SageRobots/RoboRoller/Manuals/carriage.webp

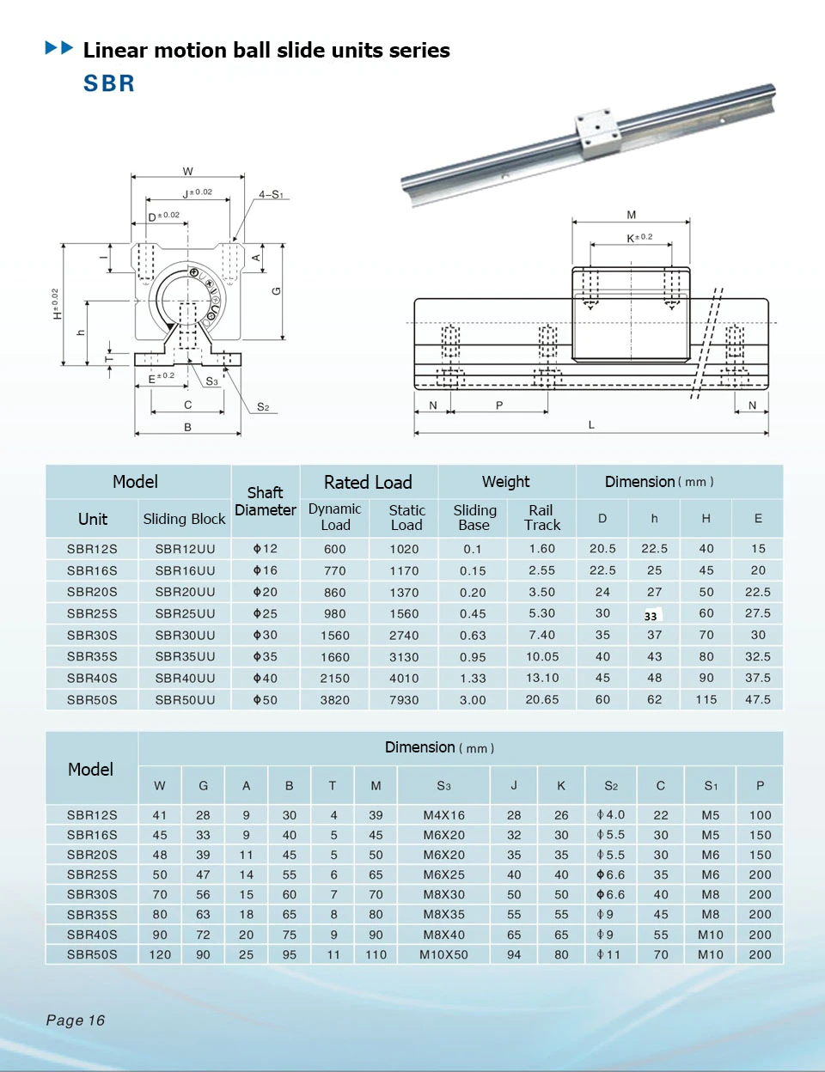
Manuals/carriage.webp
