SageRobots/RoboRoller/Cable Pinouts.ods

Load Cell Cable
1 | GND | BLK | 1 | VCC | RED
2 | Data | YEL | 2 | GND | BLK
3 | Clock | WHT | 3 | Clock | WHT
4 | VCC | RED | 4 | Data | YEL
Encoder Cable Z
1 | 2 | 3V3 | GND | RED | BLK
3 | 4 | CLK | MISO | WHT | YEL
5 | 6 | CS | MOSI | ORG | GRN
1 | 3V3 | RED
2 | GND | BLK
3 | CLK | WHT
4 | MISO | YEL
5 | CS | ORG
6 | MOSI | GRN
Home Cable
1 | 3V3 | RED | 1 | 3V3 | RED
2 | OUT | YEL | 2 | GND | BLK
3 | GND | BLK | 3 | OUT | YEL
Encoder Cable X
2 | 1 | 3V3 | GND | RED | BLK
4 | 3 | CLK | MISO | WHT | YEL
6 | 5 | CS | MOSI | ORG | GRN
1 | 3V3 | RED
2 | GND | BLK
3 | CLK | WHT
4 | MISO | YEL
5 | CS | ORG
6 | MOSI | GRN
Motor X Extension
