SageRobots/RoboRoller/BOM_MuscleRoller.ods

Type | Item | Sage Robots PN | Mfr | Mfr PN | Supplier | Price | Unit | Qty | Material Mfr | Material PN | Note
SUB | Frame |  |  |  |  |  |  | 1
FAB | Base | MR_BASE_1V0 | Sage Robots |  |  |  |  | 1
COM | Aluminum bracket 7in | AL_BRACK_7IN | NovelBee | B0833PR3L1 | Amazon | $5.39 |  | 2
COM | Screw M5x40 FH | SCREW_M5X25_F |  |  | McMaster |  |  | 4
COM | Nut M5 |  |  |  |  |  |  | 4
COM | Washer M5 oversize |  |  |  |  |  |  | 8 |  |  | Every hole in large brackets
FAB | Bar A | MR_BAR_A_1V0 | Sage Robots |  |  |  |  | 2
COM | M5x12 screw |  |  |  |  |  |  | 4 |  |  | Bracket to bar A
FAB | End cap 2020 | MR_END_CAP_1V0 | Sage Robots |  |  |  |  | 2
COM | M5 t nut |  |  |  |  |  |  | 6 |  |  | 4x bracket to bar A, 2x PCB bracket
COM | M5x10 screw |  |  |  |  |  |  | 2 |  |  | PCB bracket
SUB | X axis assembly |  |  |  |  |  |  | 1
COM | 500mm linear rail with carriages |  |  |  |  |  |  | 3
COM | M3 t nut |  |  |  |  |  |  | 4
COM | M3x14 screw |  | McMaster |  |  |  |  | 6 |  |  | Rails to bar As, 2x motor bracket
COM | M3 oversize washer |  |  |  |  |  |  | 4 |  |  | Rails to bar As
COM | Stepper motor | MTR |  |  |  |  |  | 1
FAB | Motor bracket X | MR_MTR_BRACK_X_1V0 | Sage Robots |  |  |  |  | 1
COM | M3x12 flathead screw |  |  |  |  |  |  | 4 |  |  | Motor to motor bracket
COM | M3x10 screw |  | McMaster |  |  |  |  | 4
COM | M5 t nut |  |  |  |  |  |  | 7 |  |  | 2x motor bracket, 2x encoder bracket, 2x carrier brack A, 1x mag sw PCBA
COM | M5x10 screw |  |  |  |  |  |  | 4 |  |  | 2x motor bracket, 2x enc brack
COM | Coupler 5 to 8mm |  |  |  |  |  |  | 1
FAB | Lead screw X | MR_LEAD_SCREW_X_1V0 |  |  |  |  |  | 1
FAB | Lead nut bracket X | MR_LEAD_NUT_BRACK_X_1V0 | Sage Robots |  |  |  |  | 1
COM | M3x20 screw |  |  |  |  |  |  | 8 |  |  | 4x lead nut to brack, 2x brack to rail, 2x mag brack
COM | M3 nut |  |  |  |  |  |  | 20 |  |  | 6x carrier, 2x carrier brack B, 2x lead nut brack, 4x lead nut, 4x z rail, 2x mag brack
FAB | Magnet coupler | MR_MAG_COUPLER_1V0 | Sage Robots |  |  |  |  | 1
COM | Diametric magnet 6x2.5mm |  |  |  | Digikey |  |  | 1
COM | M3x4 set screw |  |  |  |  |  |  | 1
COM | M3 square nut |  |  |  |  |  |  | 1
FAB | Encoder bracket X | MR_ENC_BRACK_X_1V0 | Sage Robots |  |  |  |  | 1
COM | #4x5/16 screw for plastic |  |  |  |  |  |  | 1 |  |  | Encoder PCB to bracket
COM | M5x16 screw |  |  |  |  |  |  | 2 |  |  | Enc brack x to bar A
COM | M5x6 screw |  |  |  |  |  |  | 1 |  |  | Mag sw PCBA
FAB | Carriage plate X | MR_CARRIAGE_PLATE_X_1V0 | Sage Robots |  |  |  |  | 2
FAB | Encoder bracket Z |  |  |  |  |  |  | 1
COM | #8x0.75 screw for plastic |  |  |  |  |  |  | 2
COM | Magnet |  |  |  | Digikey |  |  | 1
COM | M3x12 screw |  |  |  |  |  |  | 16
COM | Cable carrier |  |  |  |  |  |  | 1
FAB | Carrier bracket A | MR_CARRIER_BRACK_A_1V0 | Sage Robots |  |  |  |  | 1
 | M5x12 screw |  |  |  |  |  |  | 2 |  |  | Carrier bracket A
FAB | Carrier bracket B | MR_CARRIER_BRACK_B_1V0 | Sage Robots |  |  |  |  | 1
 | M3x16 flat head screw |  |  |  |  |  |  | 6 |  |  | 3x carrier to carrier brack B, 3x carrier to brack A
 | M3x16 screw |  |  |  |  |  |  | 4 |  |  | 4x z rail to carriage plate x
SUB | Z axis assembly |  |  |  |  |  |  | 1
COM | 450mm lead screw with nut |  |  |  |  |  |  | 1
COM | M3x20 screw |  |  |  |  |  |  | 8
 | M3 nut |  |  |  |  |  |  | 8
FAB | Motor bracket Z | MR_MTR_BRACK_Z_1V0 |  |  |  |  |  | 1
 | M3x12 screw |  |  |  |  |  |  | 12 |  |  | 8x carriage plate z to carriages
 | M3 oversize washer |  |  |  |  |  |  | 2
 | Stepper motor |  |  |  |  |  |  | 1
 | M3x8 screw |  |  |  |  |  |  | 4
 | Coupler 5 to 8mm |  |  |  |  |  |  | 1
FAB | Magnet coupler |  |  |  |  |  |  | 1
COM | Diametric magnet 6x2.5mm |  |  |  | Digikey |  |  | 1
COM | M3x4 set screw |  |  |  |  |  |  | 1
 | M3 square nut |  |  |  |  |  |  | 1
 | Home bracket Z |  |  |  |  |  |  | 1
 | M5x10 screw |  |  |  |  |  |  | 1
 | M5 nut |  |  |  |  |  |  | 1
 | Lead nut bracket Z |  |  |  |  |  |  | 1
 | M4x40 flat head screw |  |  |  |  |  |  | 2 |  |  | 2x lead nut to carriage plate
 | M4 nut |  |  |  |  |  |  | 2
 | Carriage plate Z |  |  |  |  |  |  | 1
 | Magnet |  |  |  |  |  |  | 1
COM | #4x5/16 screw for plastic |  |  |  |  |  |  | 1 |  |  | Encoder PCB to bracket
SUB | Roller assembly |  |  |  |  |  |  | 1
 | Aluminum bracket mm |  |  |  |  |  |  | 2
 | M5x25 screw |  |  |  |  |  |  | 4
 | M5 nut |  |  |  |  |  |  | 4
 | M5x14 screw |  |  |  |  |  |  | 8
 | M5 t nut |  |  |  |  |  |  | 14 |  |  | 4x LC PCB bracks, 2x carrier brack D, 4x LC brack Bs, 4x Al bracks
FAB | Bar B |  |  |  |  |  |  | 2
 | Load cell bracket B |  |  |  |  |  |  | 2
 | M4x55 screw |  |  |  |  |  |  | 4
 | Load cell 20kg |  | ShangHJ | B09CQHY73K |  |  |  | 2
 | Load cell bracket |  |  |  |  |  |  | 1
 | Load cell bracket A |  |  |  |  |  |  | 1
 | M4x20 screw |  |  |  |  |  |  | 4
 | Shoulder screw 1.25in 10-24 |  |  |  |  |  |  | 4
 | Spring |  |  |  |  |  |  | 4
 | 10-24 square nut |  |  |  |  |  |  | 4
 | Roller bracket |  |  |  |  |  |  | 2
 | Shaft 10mm |  |  |  |  |  |  | 1
 | Bearing 10mm |  |  |  |  |  |  | 2
 | Roller cap |  |  |  |  |  |  | 2
 | Roller |  |  |  |  |  |  | 1
 | Cable carrier |  |  |  |  |  |  | 1
 | Carrier bracket C |  |  |  |  |  |  | 1
 | M3x20 screw |  |  |  |  |  |  | 2
 | M3 nut |  |  |  |  |  |  | 8
 | M3x10 flat head screw |  |  |  |  |  |  | 3
 | Carrier bracket D |  |  |  |  |  |  | 1
 | M3x16 flat head screw |  |  |  |  |  |  | 3 |  |  | Carrier to carrier brack D
 | M5x10 screw |  |  |  |  |  |  | 6 |  |  | 4x LC PCB bracks, 2x carrier brack D
 | Load cell PCB bracket |  |  |  |  |  |  | 2
 | #3x0.25 screw |  |  |  |  |  |  | 4
 | Load cell PCB |  |  |  |  |  |  | 2
SUB | PCB assembly |  |  |  |  |  |  | 1
FAB | Muscle roller PCB |  |  |  | JLCPCB |  |  | 1
COM | DRV8825 breakout |  |  |  |  |  |  | 2
COM | Female header 8 pos P2.54 |  | Adam Tech | RS1-08-G | Digikey |  |  | 4
COM | Capacitor 100u |  | KEMET | EDK107M016A9GAA | Digikey |  | $0.39 | 0 |  |  | C2, C3
COM | Capacitor 100u |  | Würth Elektronik | 865080343009 | Digikey |  | $0.27 | 2 |  |  | C2, C3
COM | Capacitor 0805 22u |  | Samsung Electro-Mechanics | CL21A226MOQNNNE‎ | Digikey |  |  | 2 |  |  | C1, C5
COM | Capacitor 0805 0.1u |  | Samsung Electro-Mechanics | CL21F104ZAANNNC | Digikey |  |  | 1 |  |  | C6
COM | Capacitor 0805 1u |  | Samsung Electro-Mechanics | CL21B105KOFNNNE | Digikey |  |  | 1 |  |  | C4
COM | Connector 1x6 male |  | JST |  |  |  |  | 2
COM | Screw terminal 1x2 |  | Adam Tech | EBBA-02-C-SS-BU | Digikey |  |  | 2
COM | Connector 1x4 |  | JST |  |  |  |  | 4
COM | Connector 1x3 |  | JST |  | Digikey |  |  | 2
COM | Pin header 1x3 P2.54 |  |  |  |  |  |  | 1
COM | Resistor 0805 47k |  |  |  |  |  |  | 2 |  |  | R1, R3
COM | Resistor 0805 10k |  |  |  |  |  |  | 3 |  |  | R2, R4, R5
COM | Tactile switch |  | E-Switch | TL3305AF160QG | Digikey |  |  | 2
COM | DC DC converter 3.3Vout |  | Diodes Incorporated | AZ1117IH-3.3TRG1 | Digikey |  |  | 0
COM | DC DC converter 3.3Vout |  | STMicroelectronics | LD1117ADT33TR | Digikey |  | $0.63 | 1
COM | WiFi BT microcontroller |  | Espressif | ESP32-WROOM-32E | Digikey |  |  | 1
SUB | Z motor cable assembly |  |  |  |  |  |  | 1
 | Cable 4 cond 26AWG |  |  |  |  |  | m | 0.13
 | Connector 1x4 female |  | JST |  |  |  |  | 1
COM | Crimp contact |  | JST |  |  |  |  | 4
 | Connector 1x4 female |  | TE |  |  |  |  | 1
COM | Crimp contact female |  | TE |  |  |  |  | 4
 | Connector 1x4 male |  | TE |  |  |  |  | 1
COM | Crimp contact male |  | TE |  |  |  |  | 4
SUB | Load cell cable assembly |  |  |  |  |  |  | 2
 | Cable 4 cond 22AWG |  |  |  |  |  | m | 1.4
 | Connector 1x4 female |  | JST |  |  |  |  | 3
COM | Crimp contact |  | JST |  |  |  |  | 12
SUB | Encoder PCB assembly |  |  |  |  |  |  | 2
 | Encoder PCB |  |  |  | JLCPCB |  |  | 1
 | Magnetic encoder |  | AMS | 5047D |  |  |  | 1
 | Capacitor 0805 0.1u |  |  |  |  |  |  | 1
 | Header male 2x3 P2 |  |  |  | Digikey |  |  | 1
SUB | Encoder cable assembly |  |  |  |  |  |  | 2
 | Cable 6 cond 26AWG |  |  |  |  |  | m | 1
 | Connector 2x3 female P2 |  |  |  |  |  |  | 1
 | Crimp contact female |  |  |  |  |  |  | 6
 | Connector 1x6 female |  | JST |  |  |  |  | 1
COM | Crimp contact female |  | JST |  |  |  |  | 6
SUB | Magnetic switch PCB assembly |  |  |  |  |  |  | 2
 | Magnetic switch PCB |  |  |  | JLCPCB |  |  | 1
 | Magnetic switch omnipolar |  |  |  |  |  |  | 1
 | Connector 1x3 male |  | JST |  |  |  |  | 1
SUB | Magnetic switch cable assembly Z |  |  |  |  |  |  | 2
 | Cable 3 cond 26AWG |  |  |  |  |  | m | 1.3
 | Connector 1x3 female |  | JST |  |  |  |  | 2
COM | Crimp contact female |  | JST |  |  |  |  | 6
