SageRobots/RoboRoller/FreeCAD/4000-0006-0008 assembly.STEP

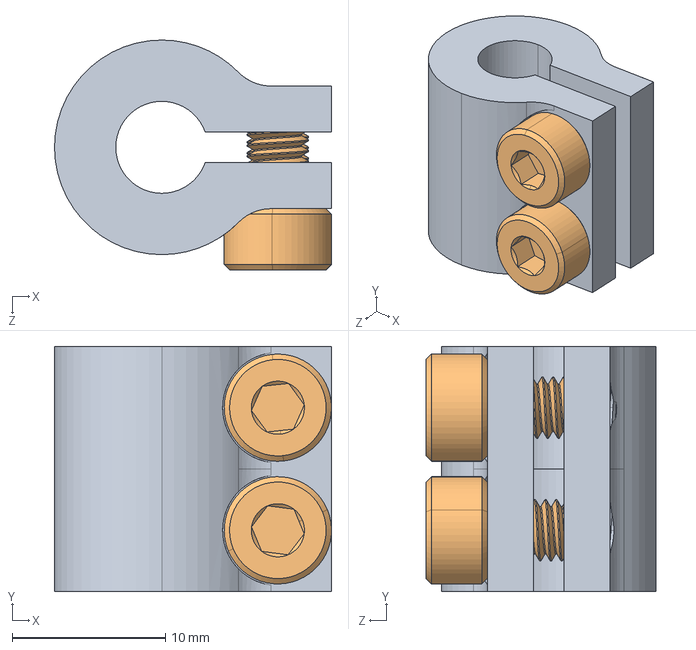
[picture p2: CAD file, 2021-10-21]
FreeCAD/4000-0006-0008 assembly.STEP
18.1 x 16.0 x 15.0 mm
2800-0004-0008_90128A207 x 2
