SageRobots/RoboRoller/FreeCAD/AL_BRACKET.FCStd

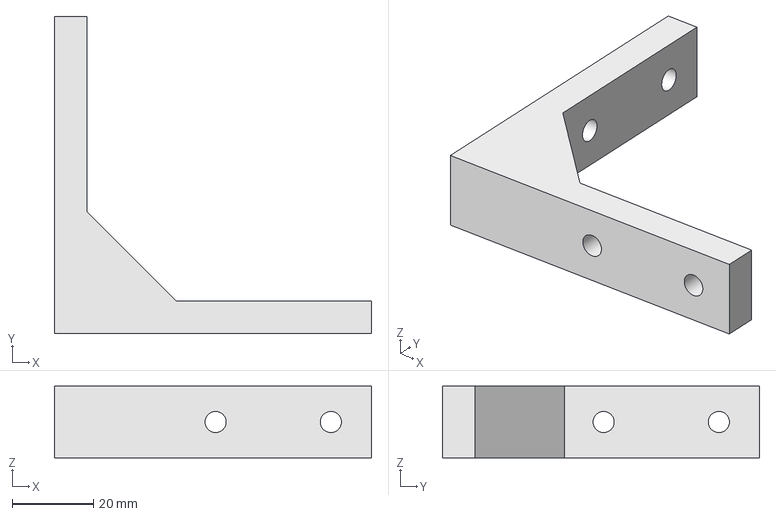
[picture p3: CAD file, 2022-08-25]
FreeCAD/AL_BRACKET.FCStd
78.0 x 78.0 x 17.7 mm
