SageRobots/RoboRoller/STL/Z_MAG_BRACK_1V0.stl

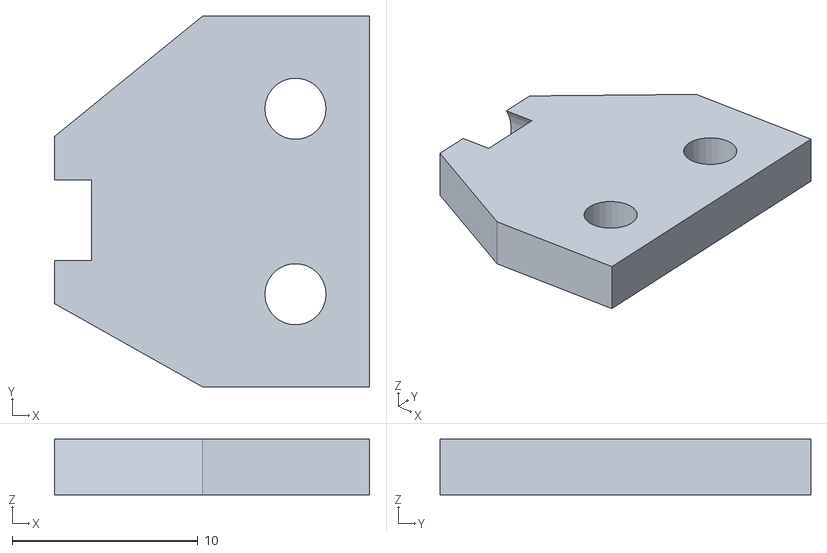
[picture p4: CAD file, 2022-07-25]
STL/Z_MAG_BRACK_1V0.stl
17.0 x 20.0 x 3.00
