SageRobots/RoboRoller/FreeCAD/AL_BRACKET_A.FCStd

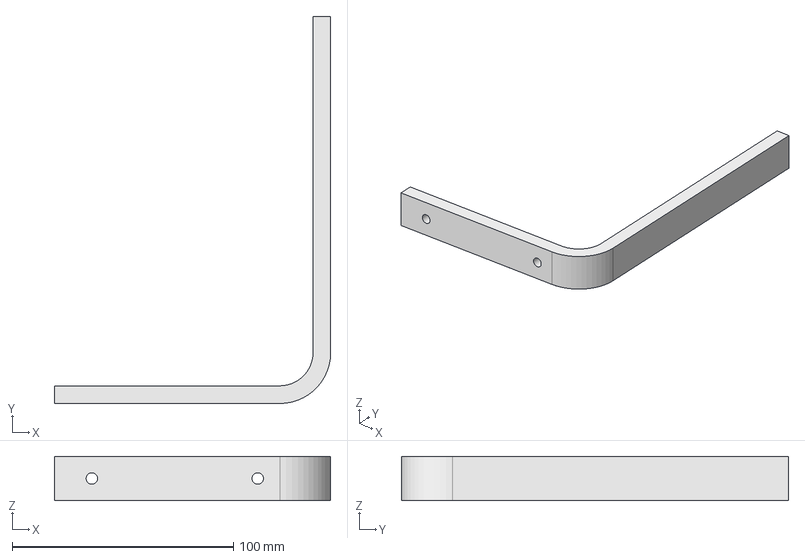
[picture p5: CAD file, 2022-08-25]
FreeCAD/AL_BRACKET_A.FCStd
125.0 x 175.0 x 20.0 mm
