SageRobots/RoboRoller/STL/X_MAG_BRACK_1V0.stl

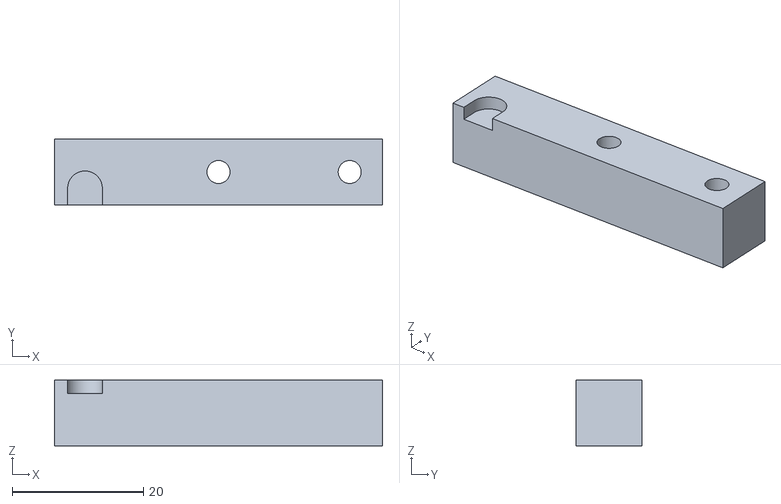
[picture p6: CAD file, 2022-07-25]
STL/X_MAG_BRACK_1V0.stl
50.0 x 10.0 x 10.0
