SageRobots/RoboRoller/FreeCAD/MTR_17HS15_1504S.FCStd

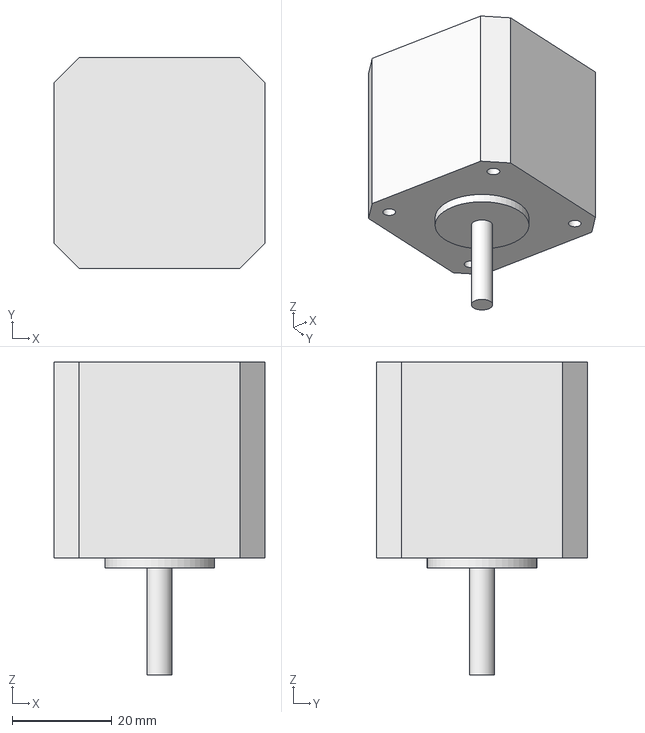
[picture p7: CAD file, 2022-08-25]
FreeCAD/MTR_17HS15_1504S.FCStd
42.3 x 42.3 x 62.8 mm
