SageRobots/RoboRoller/STL/LC_PCB_BRACK_1V0.stl

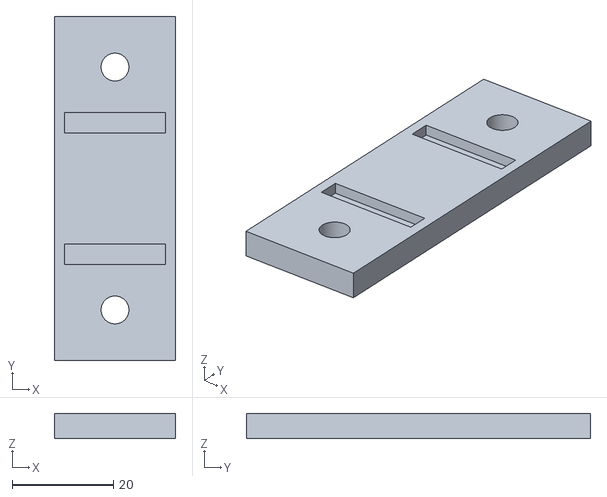
[picture p8: CAD file, 2022-07-12]
STL/LC_PCB_BRACK_1V0.stl
24.0 x 68.0 x 5.00
