SageRobots/RoboRoller/STL/ROLLER_CAP_1V0.stl

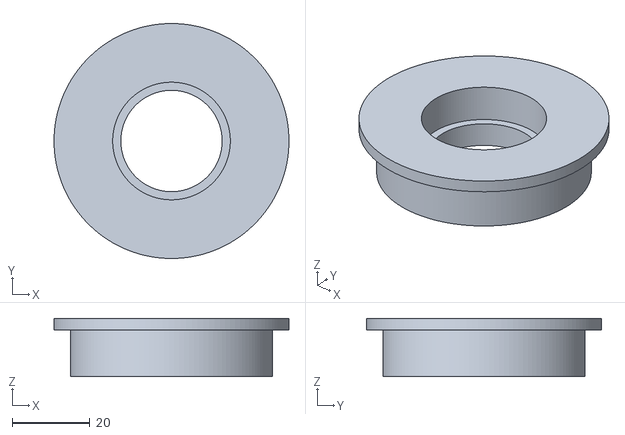
[picture p9: CAD file, 2022-07-12]
STL/ROLLER_CAP_1V0.stl
60.3 x 60.3 x 15.0
