SageRobots/RoboRoller/FreeCAD/LOAD-CELL-4543.FCStd

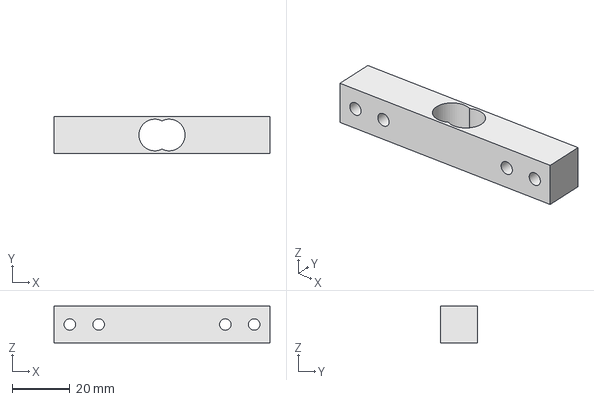
[picture p10: CAD file, 2022-08-25]
FreeCAD/LOAD-CELL-4543.FCStd
75.0 x 12.7 x 12.7 mm
