SageRobots/RoboRoller/STL/ENC_BRACK_Z_1V0.stl

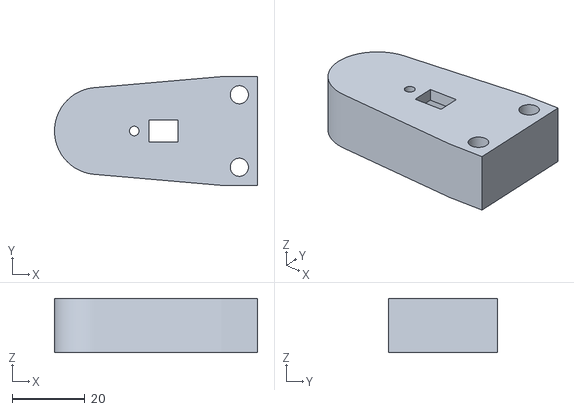
[picture p11: CAD file, 2022-06-04]
STL/ENC_BRACK_Z_1V0.stl
56.0 x 30.0 x 15.0
