SageRobots/RoboRoller/FreeCAD/MUSCLE_ROLLER_1V0.FCStd

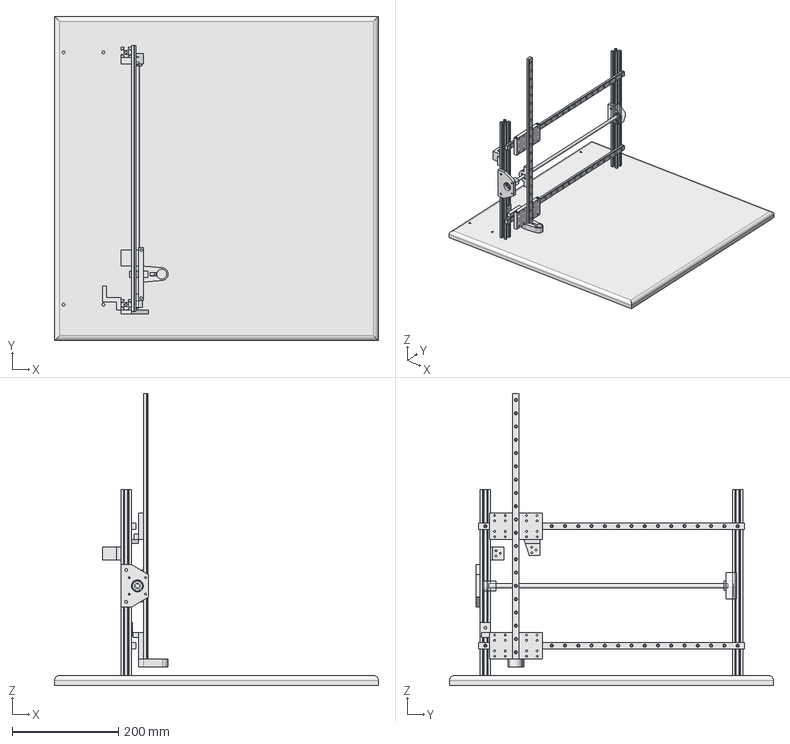
[picture p12: CAD file, 2022-08-25]
FreeCAD/MUSCLE_ROLLER_1V0.FCStd
610.0 x 610.0 x 550.4 mm
