SageRobots/RoboRoller/STL/ENC_BRACK_X_1V0.stl

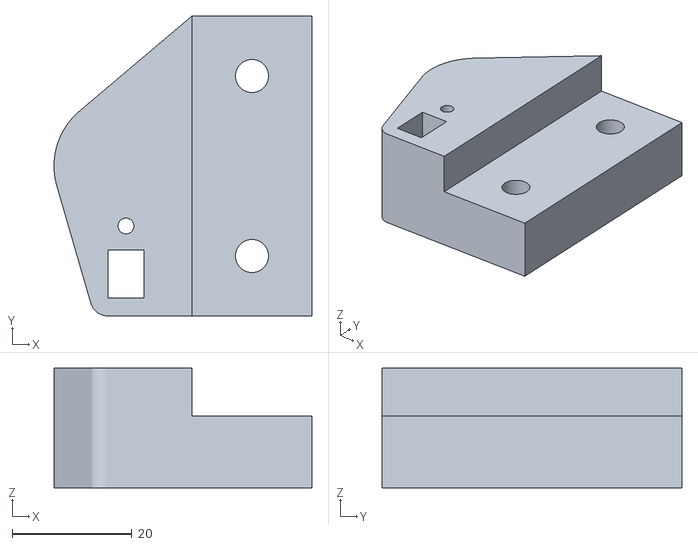
[picture p13: CAD file, 2022-06-04]
STL/ENC_BRACK_X_1V0.stl
43.0 x 50.0 x 20.0
