SageRobots/RoboRoller/FreeCAD/SPRING.FCStd

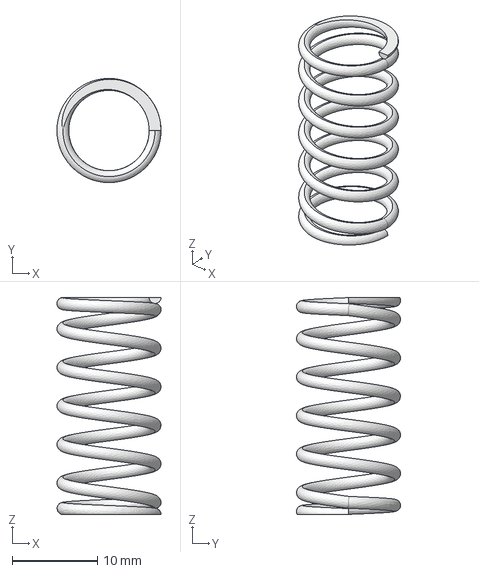
[picture p14: CAD file, 2022-08-25]
FreeCAD/SPRING.FCStd
12.2 x 12.2 x 25.4 mm
