SageRobots/RoboRoller/STL/PCB_BRACK_1V0.stl

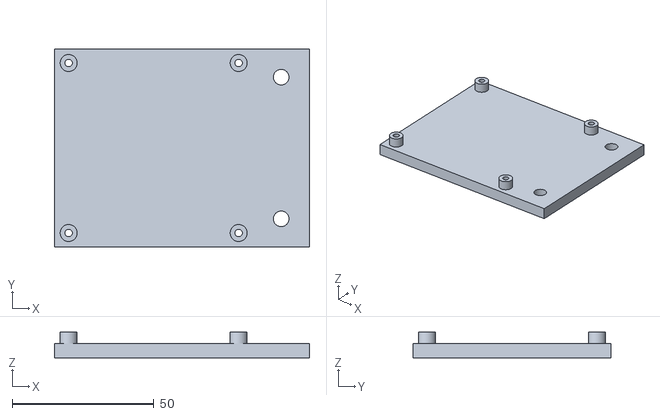
[picture p15: CAD file, 2022-06-04]
STL/PCB_BRACK_1V0.stl
90.0 x 70.0 x 9.00
