SageRobots/RoboRoller/FreeCAD/CARRIAGE_MGN12H.FCStd

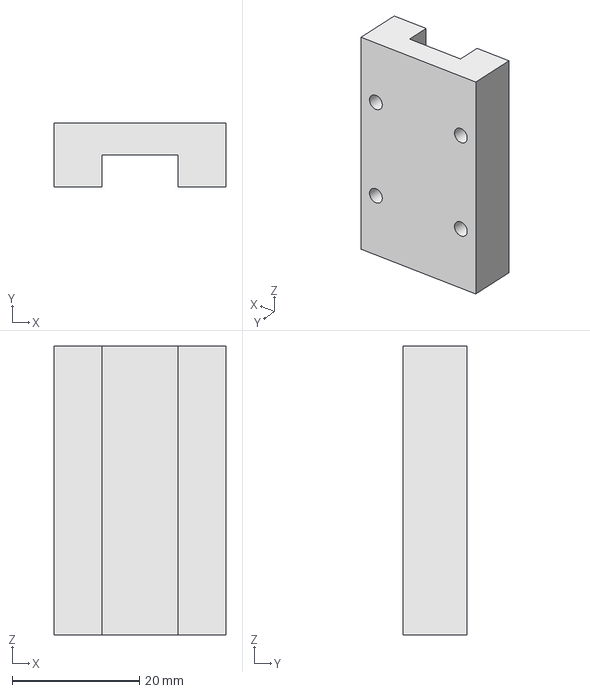
[picture p16: CAD file, 2022-08-25]
FreeCAD/CARRIAGE_MGN12H.FCStd
27.0 x 10.0 x 45.4 mm
