SageRobots/RoboRoller/STL/MTR_BRACK_Z_1V0.stl

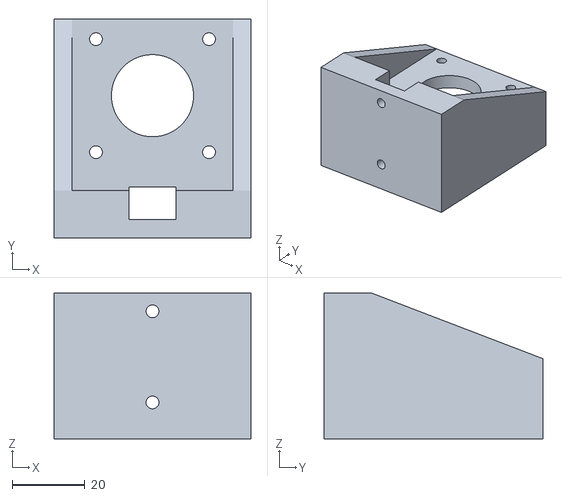
[picture p17: CAD file, 2022-06-04]
STL/MTR_BRACK_Z_1V0.stl
54.0 x 60.0 x 40.0
