SageRobots/RoboRoller/FreeCAD/CARRIAGE_SBR16.FCStd

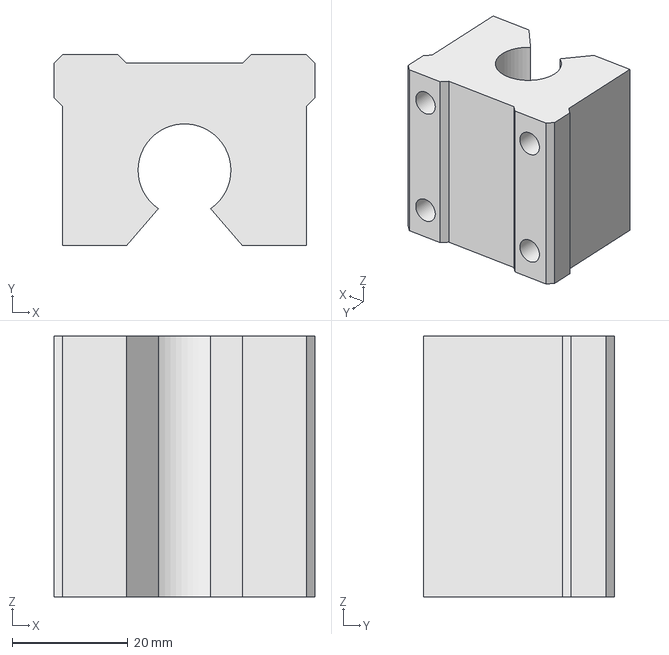
[picture p18: CAD file, 2022-01-11]
FreeCAD/CARRIAGE_SBR16.FCStd
45.0 x 33.0 x 45.0 mm
