SageRobots/RoboRoller/STL/CARRIER_BRACK_B_1V0.stl

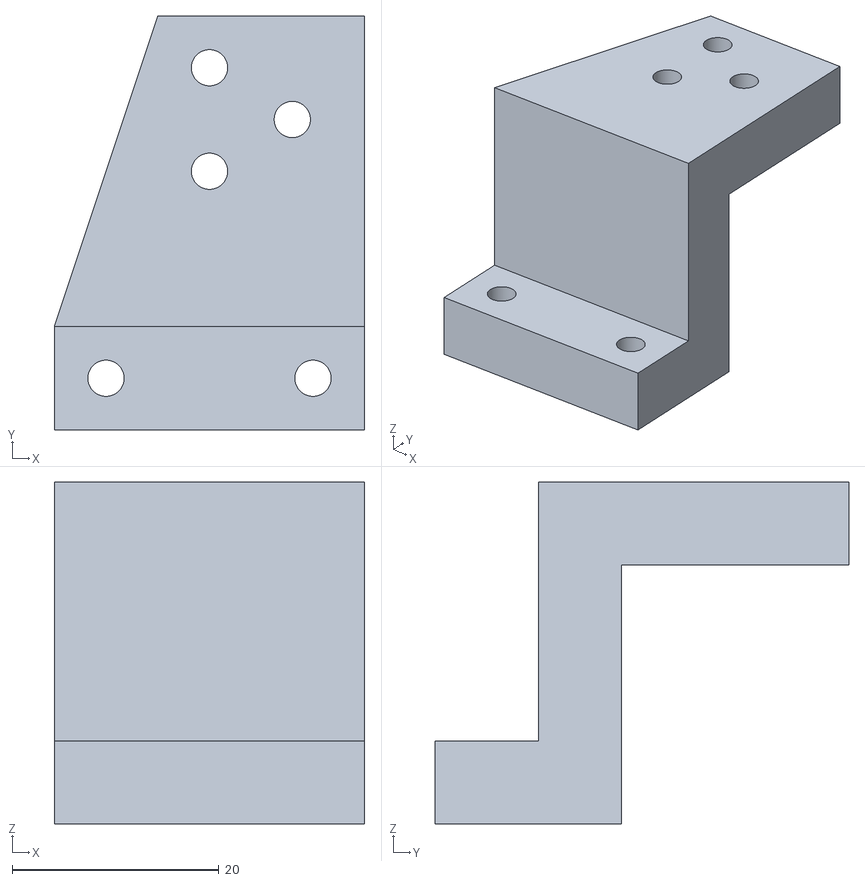
[picture p19: CAD file, 2022-01-28]
STL/CARRIER_BRACK_B_1V0.stl
30.0 x 40.0 x 33.0
