SageRobots/RoboRoller/FreeCAD/V-WHEEL-2020.FCStd

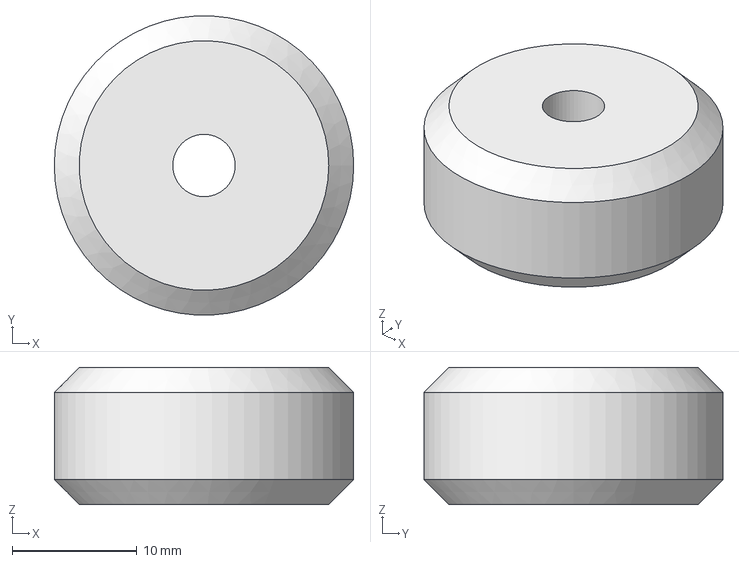
[picture p20: CAD file, 2021-12-02]
FreeCAD/V-WHEEL-2020.FCStd
24.0 x 24.0 x 11.0 mm
