SageRobots/RoboRoller/STL/CARRIER_BRACK_C_1V0.stl

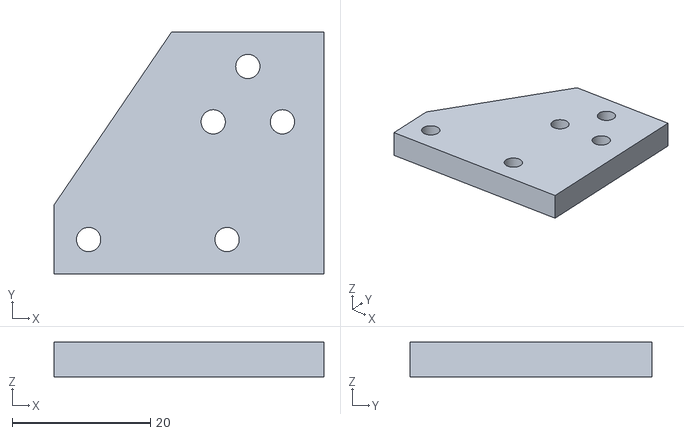
[picture p21: CAD file, 2022-01-28]
STL/CARRIER_BRACK_C_1V0.stl
39.0 x 35.0 x 5.00
