SageRobots/RoboRoller/FreeCAD/MOTOR-17HS13-0404S-PG27.FCStd

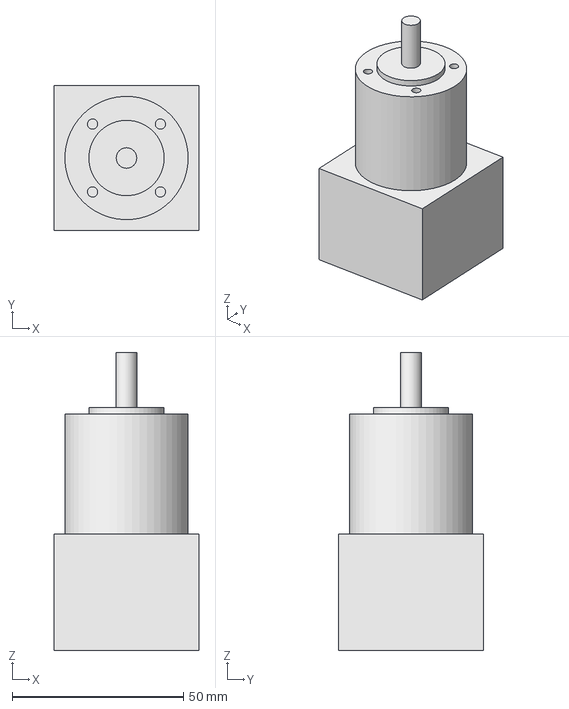
[picture p22: CAD file, 2021-12-02]
FreeCAD/MOTOR-17HS13-0404S-PG27.FCStd
42.3 x 42.3 x 87.0 mm
