SageRobots/RoboRoller/STL/MTR_BRACK_X_1V0.stl

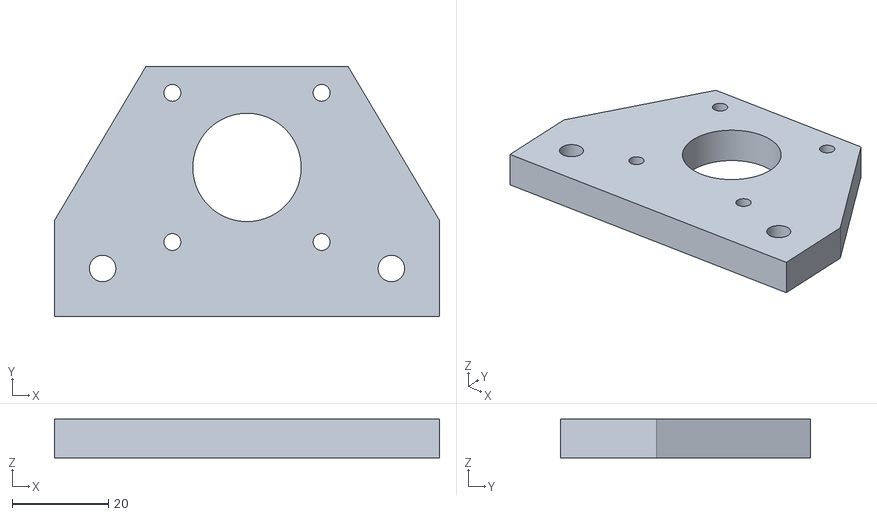
[picture p23: CAD file, 2022-01-28]
STL/MTR_BRACK_X_1V0.stl
80.0 x 52.0 x 8.00
