SageRobots/RoboRoller/STL/CARRIER_BRACK_D_1V0.stl

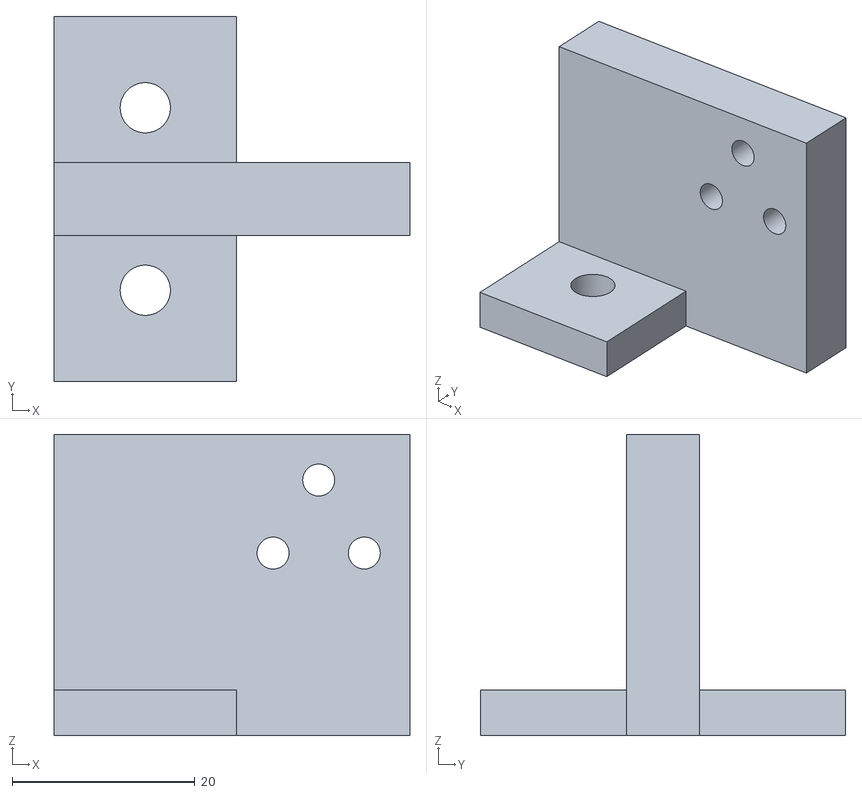
[picture p24: CAD file, 2022-01-28]
STL/CARRIER_BRACK_D_1V0.stl
39.0 x 40.0 x 33.0
