SageRobots/RoboRoller/STL/CARRIER_BRACK_A_1V0.stl

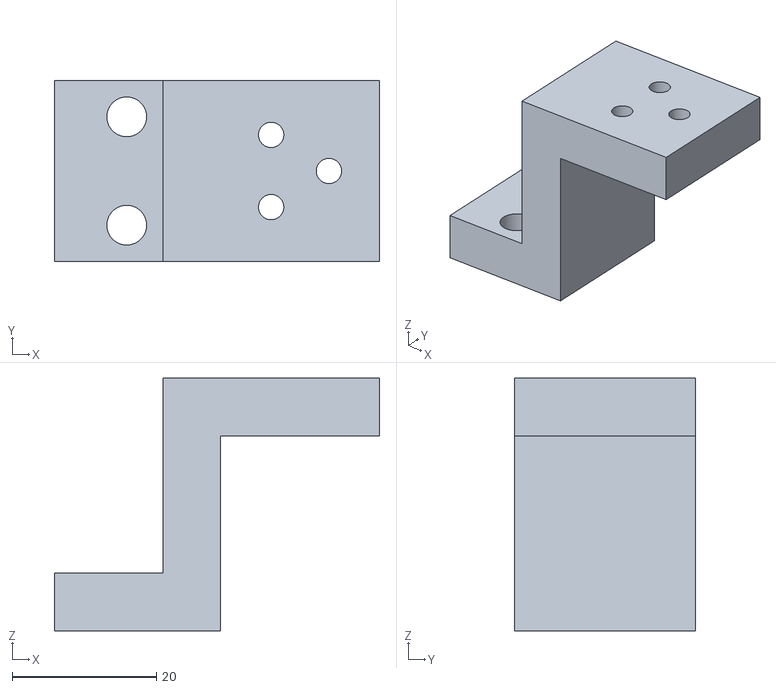
[picture p25: CAD file, 2022-01-28]
STL/CARRIER_BRACK_A_1V0.stl
45.0 x 25.0 x 35.0
