SageRobots/RoboRoller/STL/END_CAP_1V0.stl

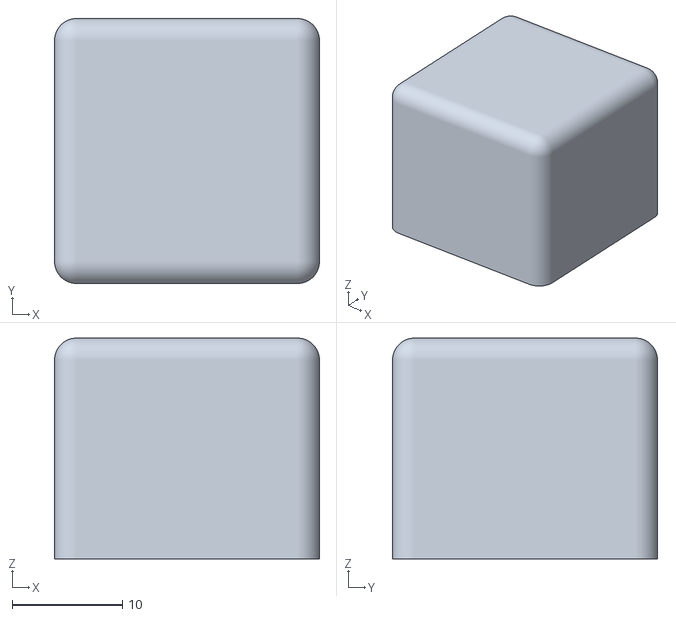
[picture p26: CAD file, 2022-01-28]
STL/END_CAP_1V0.stl
24.0 x 24.0 x 20.0
