SageRobots/RoboRoller/STL/MAGNET_COUPLER_1V0.stl

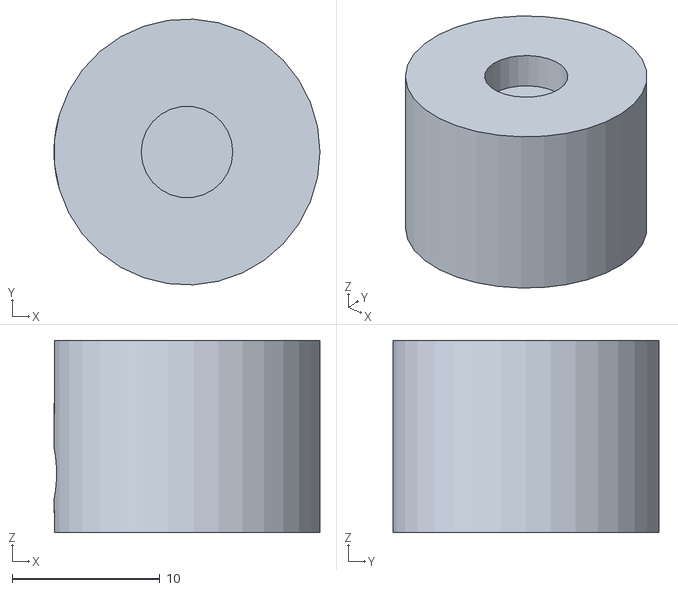
[picture p27: CAD file, 2022-01-28]
STL/MAGNET_COUPLER_1V0.stl
18.0 x 18.0 x 13.0
