SageRobots/RoboRoller/STL/CARRIAGE_PLATE_Z_1V0.stl

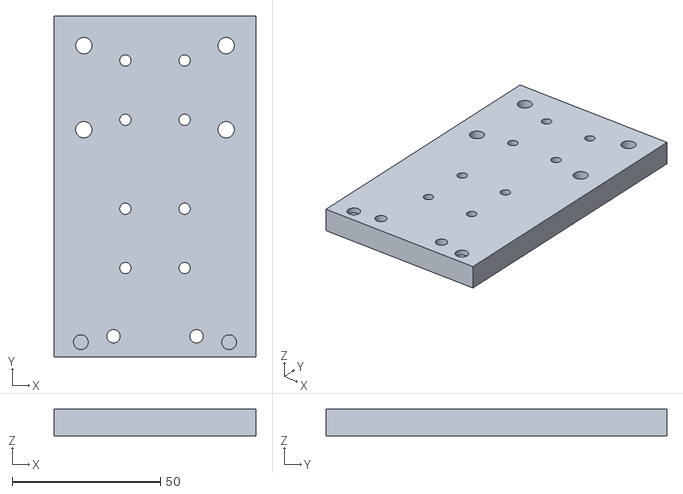
[picture p28: CAD file, 2022-01-28]
STL/CARRIAGE_PLATE_Z_1V0.stl
68.0 x 115.0 x 9.00
