SageRobots/RoboRoller/STL/HOME_BRACK_Z_1V0.stl

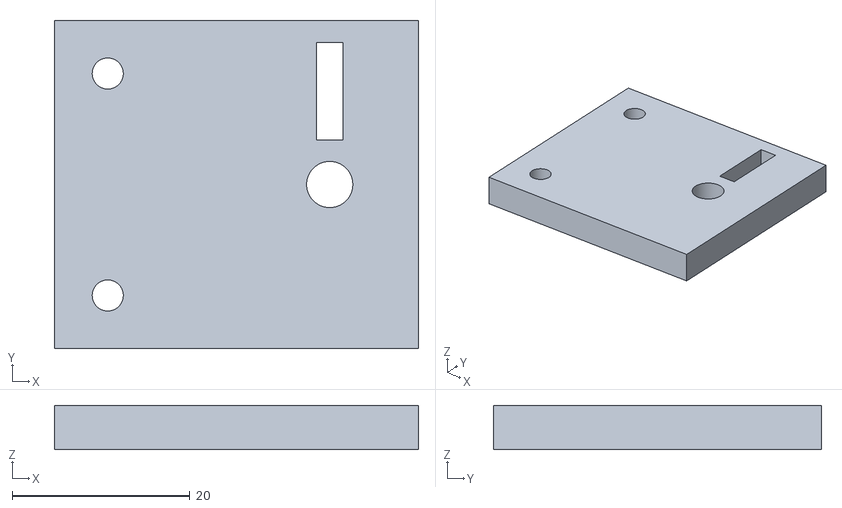
[picture p29: CAD file, 2022-01-28]
STL/HOME_BRACK_Z_1V0.stl
41.0 x 37.0 x 5.00
