SageRobots/RoboRoller/STL/CARRIAGE_PLATE_X_1V0.stl

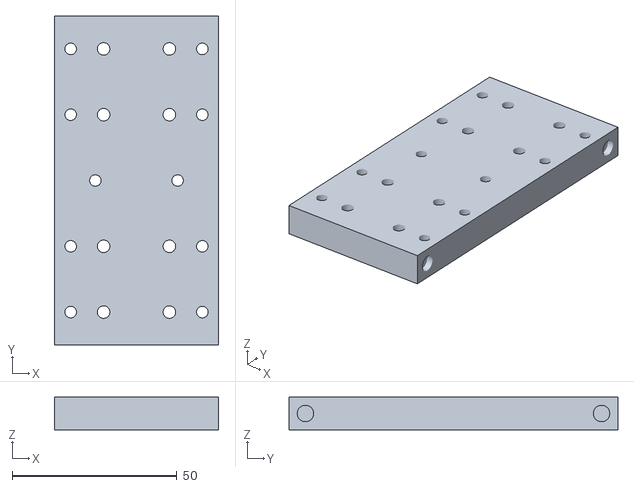
[picture p30: CAD file, 2022-01-28]
STL/CARRIAGE_PLATE_X_1V0.stl
50.0 x 100.0 x 10.0
