SageRobots/RoboRoller/STL/LC_BRACK_B_1V0.stl

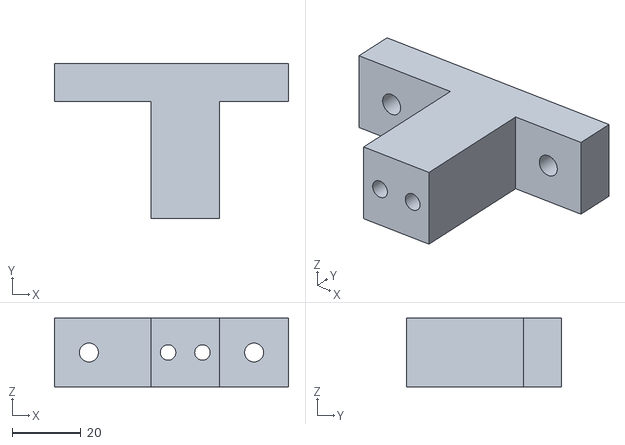
[picture p31: CAD file, 2022-01-28]
STL/LC_BRACK_B_1V0.stl
68.0 x 45.0 x 20.0
