SageRobots/RoboRoller/STL/LC_BRACK_A_1V0.stl

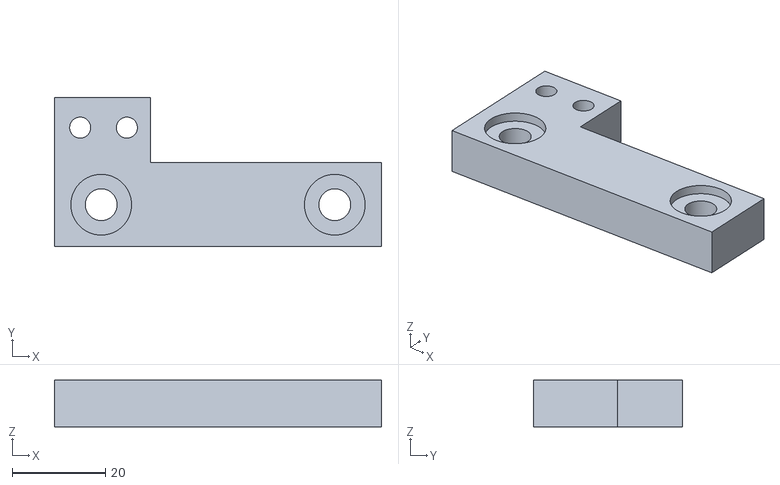
[picture p32: CAD file, 2021-10-22]
STL/LC_BRACK_A_1V0.stl
70.0 x 32.0 x 10.0
