SageRobots/RoboRoller/STL/ROLLER_BRACK_1V0.stl

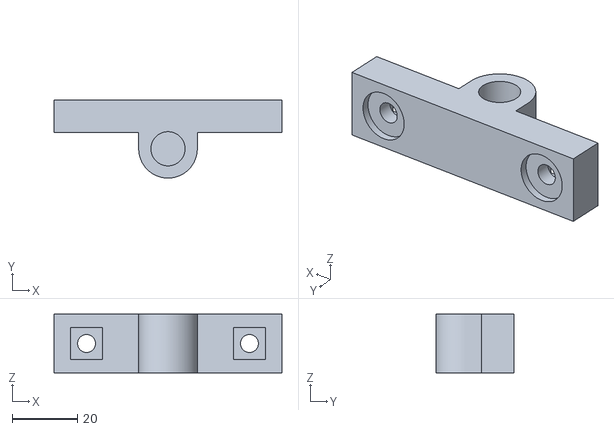
[picture p33: CAD file, 2021-10-22]
STL/ROLLER_BRACK_1V0.stl
70.0 x 24.0 x 18.0
