SageRobots/RoboRoller/(list of files, cad)

Other CAD files:
FreeCAD/COUPLER-6-8.FCStd
STL/LC_BRACK_1V0.stl
FreeCAD/SHOULDER-SCREW.FCStd
STL/LEAD_NUT_BRACK_X_1V0.stl
STL/LEAD_NUT_BRACK_Z_1V0.stl
