SageRobots/RoboRoller/Manuals/4543_diagram.jpg

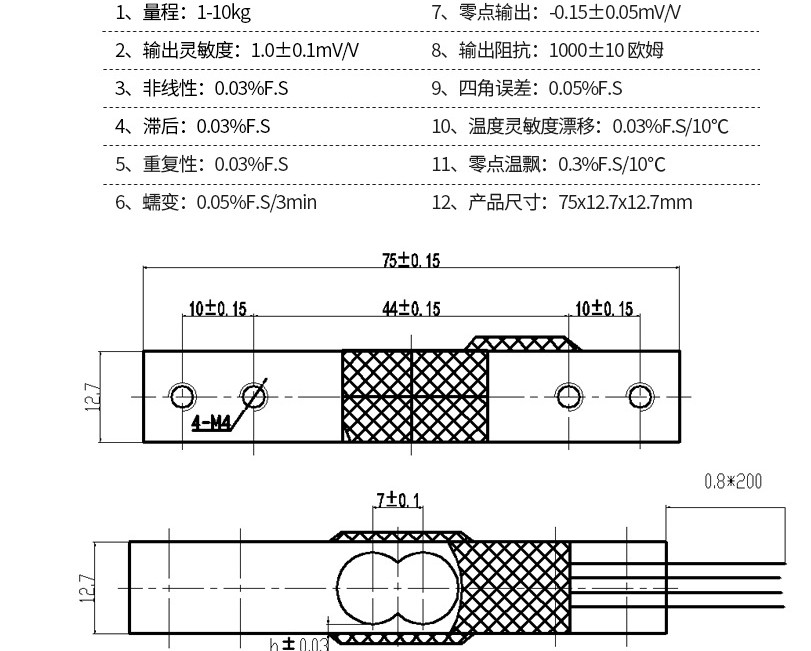
Manuals/4543_diagram.jpg
