SageRobots/RoboRoller/Manuals/cable carrier.jpg

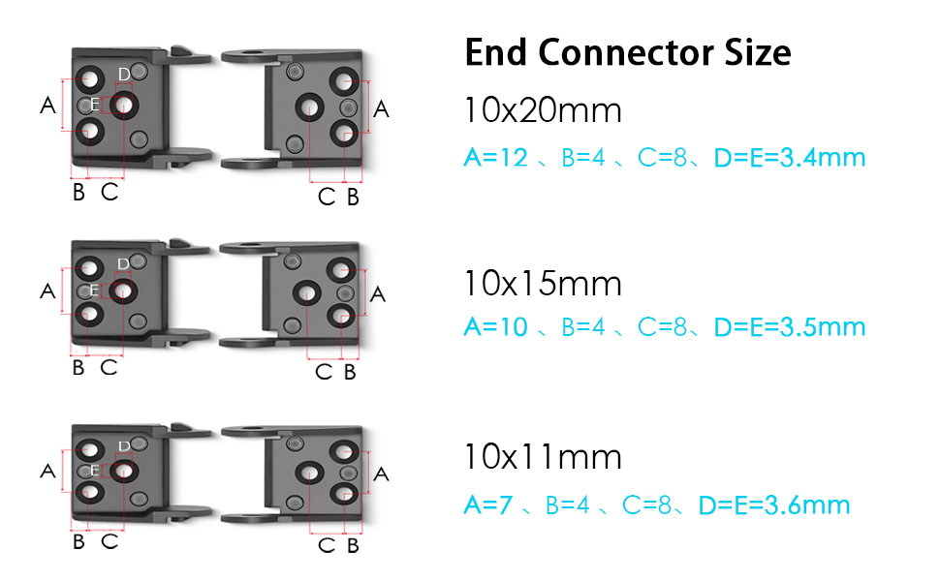
Manuals/cable carrier.jpg
