SageRobots/RoboRoller/Manuals/MGN12H rail.jpg

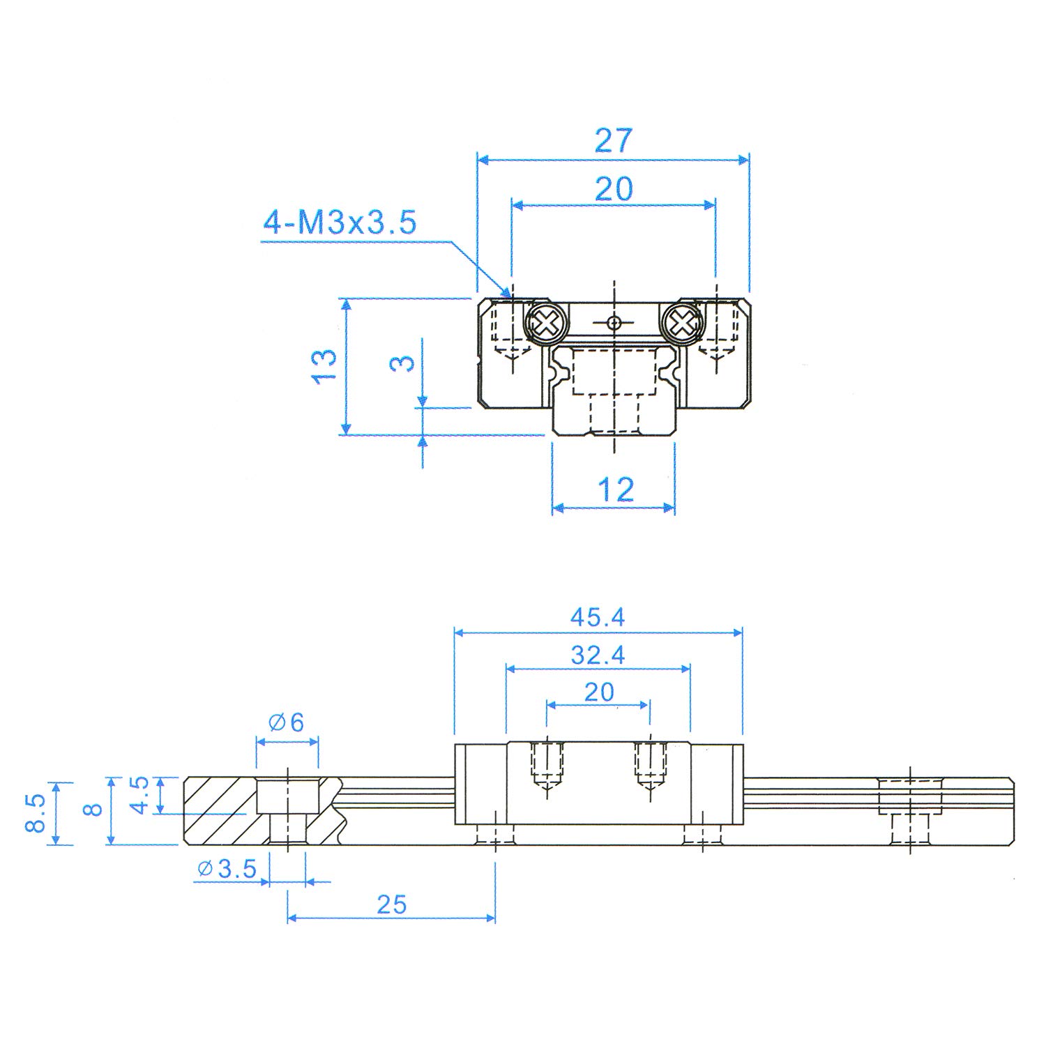
Manuals/MGN12H rail.jpg
