SageRobots/RoboRoller/Manuals/rail.jpg

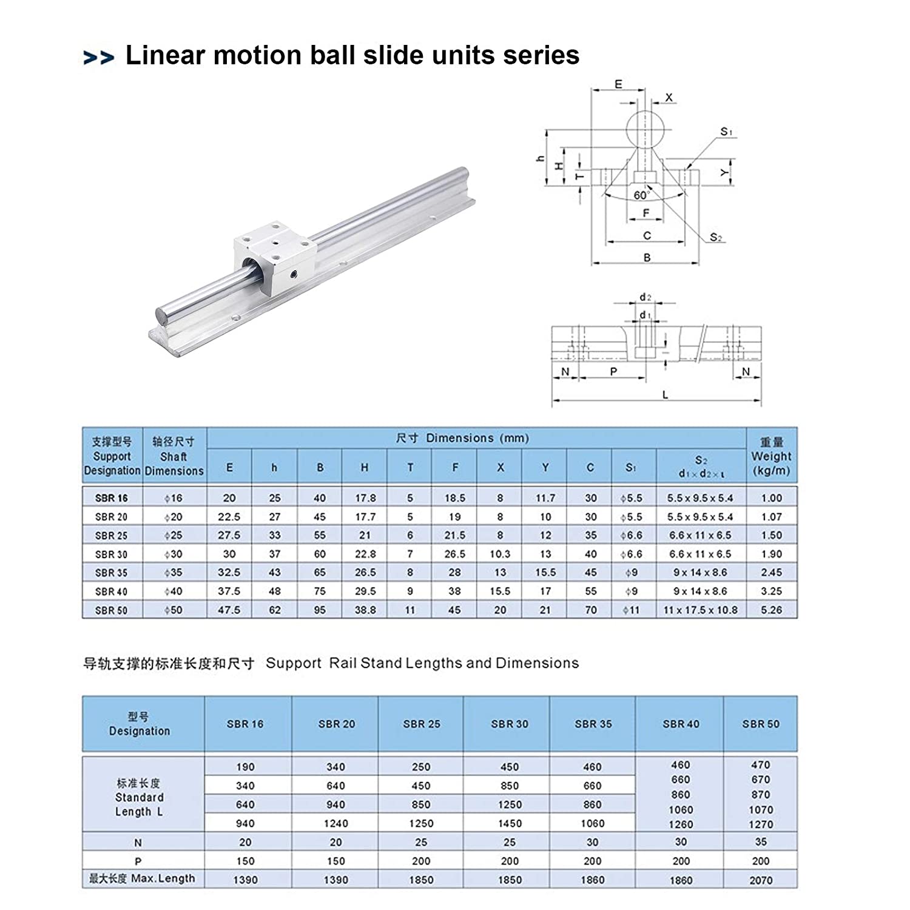
Manuals/rail.jpg
