SageRobots/RoboRoller/Manuals/93897A450_Nylon Shoulder Screws.PDF

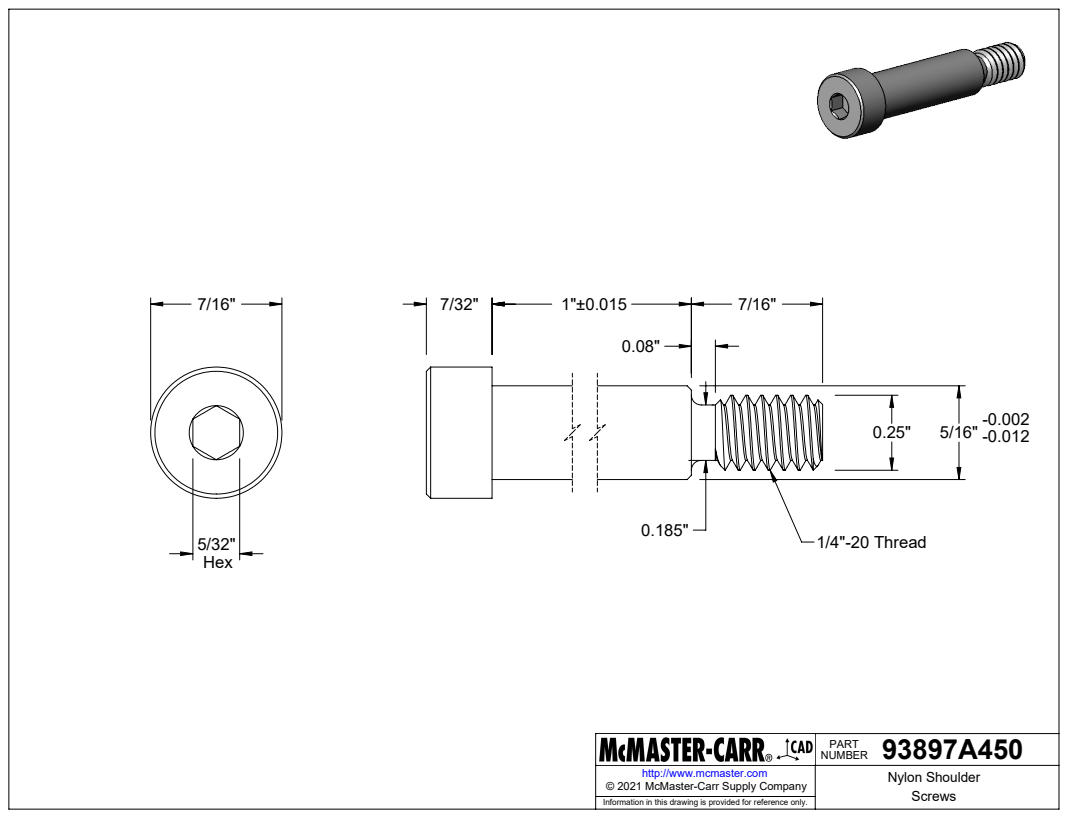
[picture p38: page 1]
1/4"-20 Thread

93897A450 PART NUMBER

http://www.mcmaster.com | Nylon Shoulder Screws © 2021 McMaster-Carr Supply Company

Information in this drawing is provided for reference only.
