SageRobots/RoboRoller/Manuals/94855A247_Low-Strength Steel Square Nut.PDF

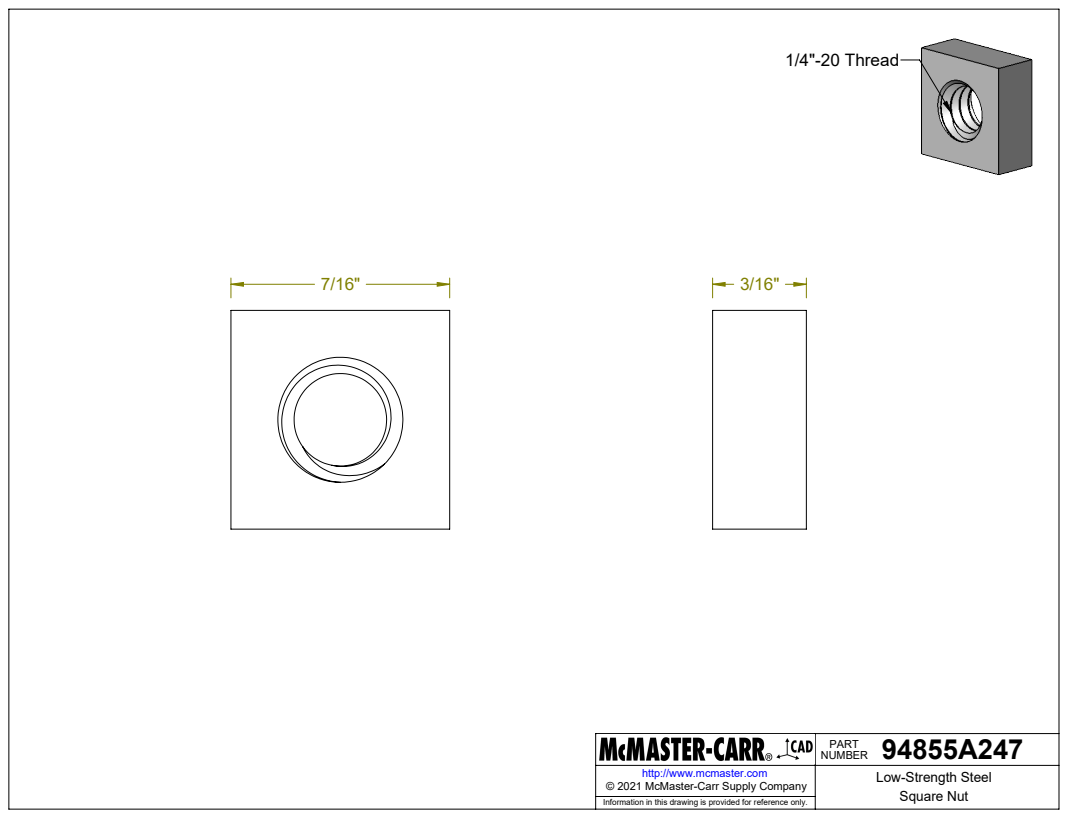
[picture p39: page 1]
1/4"-20 Thread

94855A247 PART NUMBER

http://www.mcmaster.com | Low-Strength Steel Square Nut © 2021 McMaster-Carr Supply Company

Information in this drawing is provided for reference only.
