SageRobots/RoboRoller/Manuals/9657K311_Compression Spring.PDF

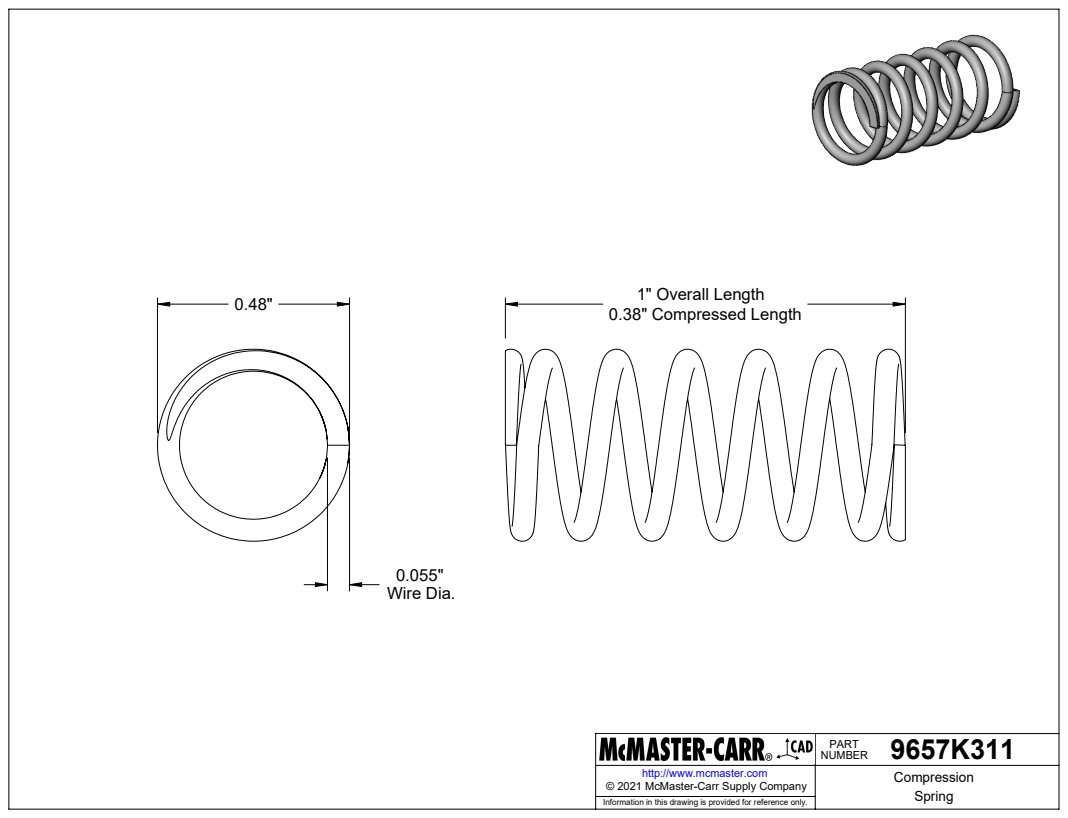
[picture p40: page 1]
Wire Dia.; 1" Overall Length; 0.38" Compressed Length

9657K311 PART NUMBER

http://www.mcmaster.com | Compression Spring © 2021 McMaster-Carr Supply Company

Information in this drawing is provided for reference only.
