SageRobots/RoboRoller/Manuals/5972K101_Ball Bearing.PDF

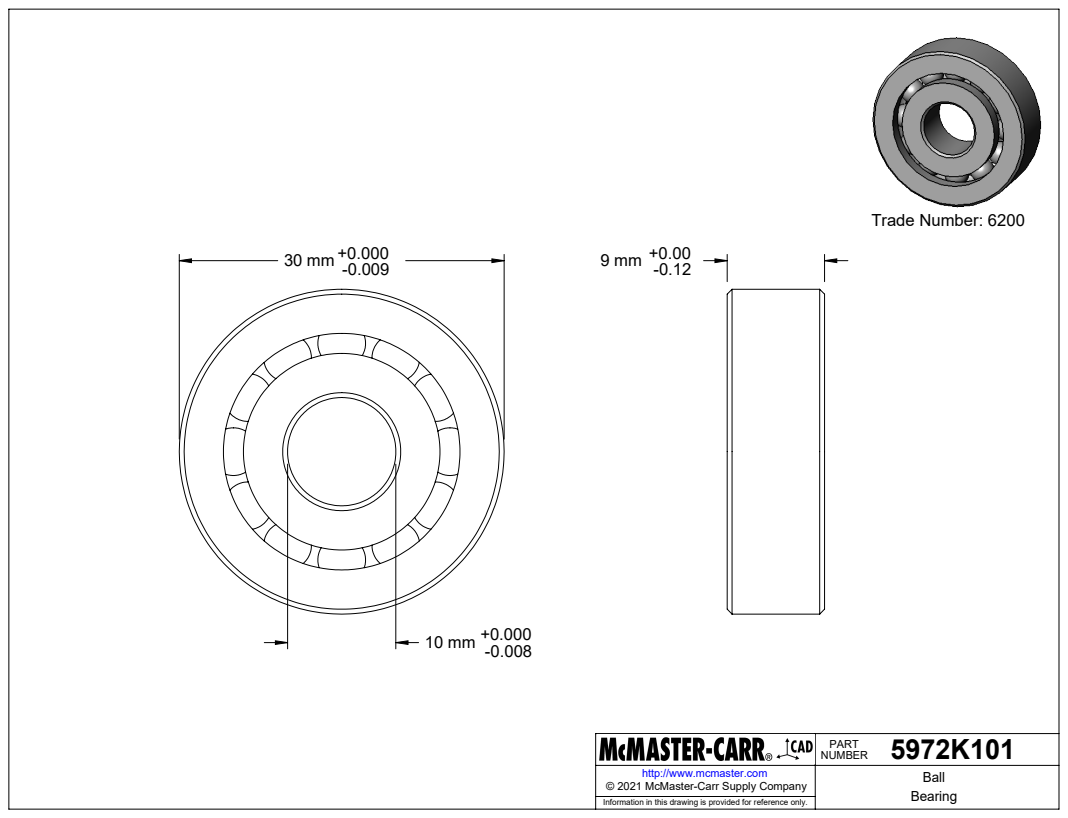
[picture p41: page 1]
Trade Number: 6200

5972K101 PART NUMBER

http://www.mcmaster.com | Ball Bearing © 2021 McMaster-Carr Supply Company

Information in this drawing is provided for reference only.
