SageRobots/RoboRoller/FreeCAD/BASE_1V0.pdf

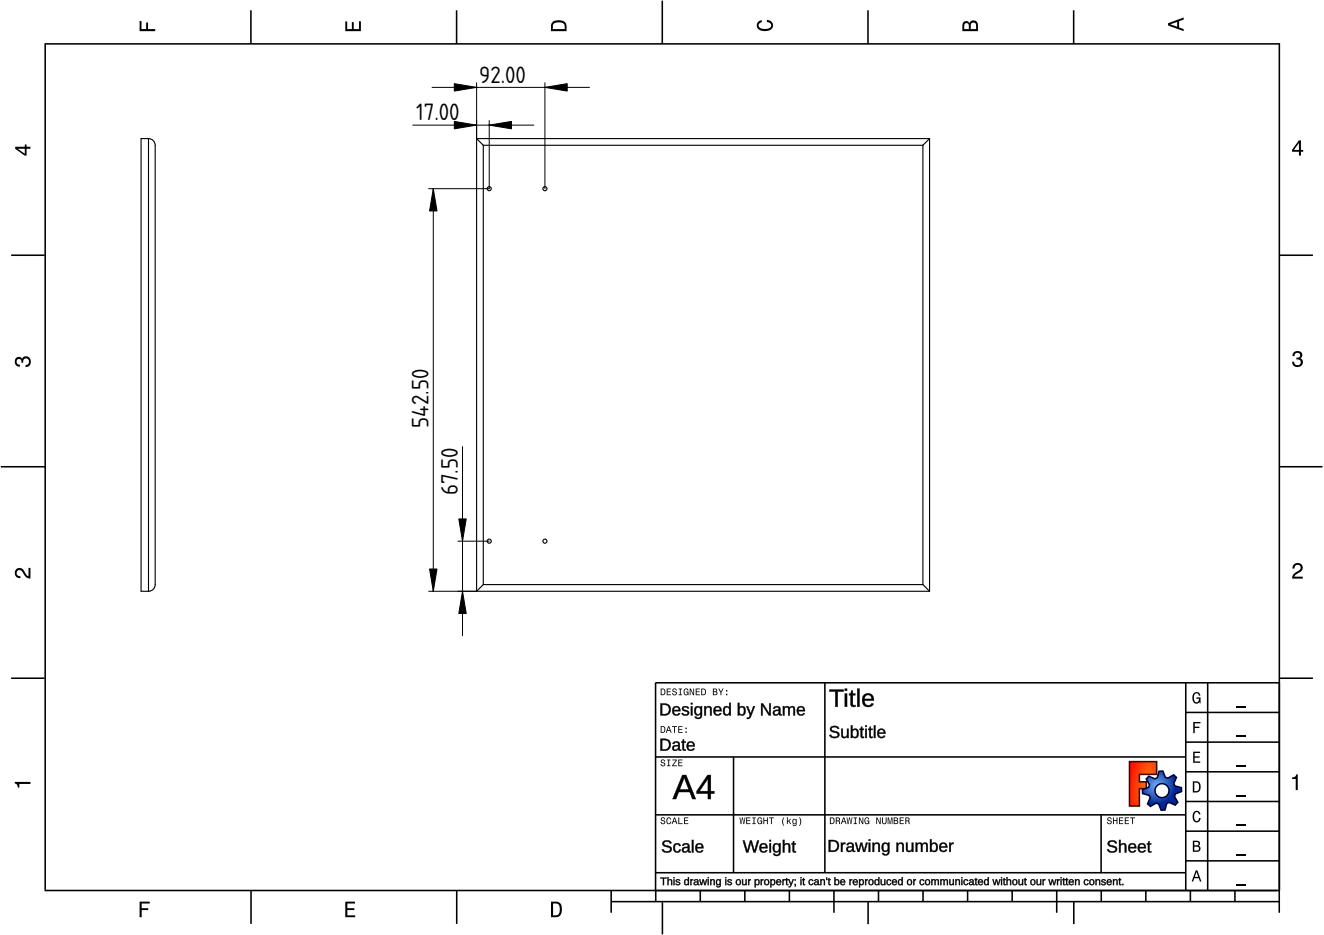
[picture p42: page 1]
