SageRobots/RoboRoller/PCB/MuscleRoller.kicad_pcb

## KiCad design PCB/MuscleRoller.kicad_pcb (2022-08-24)

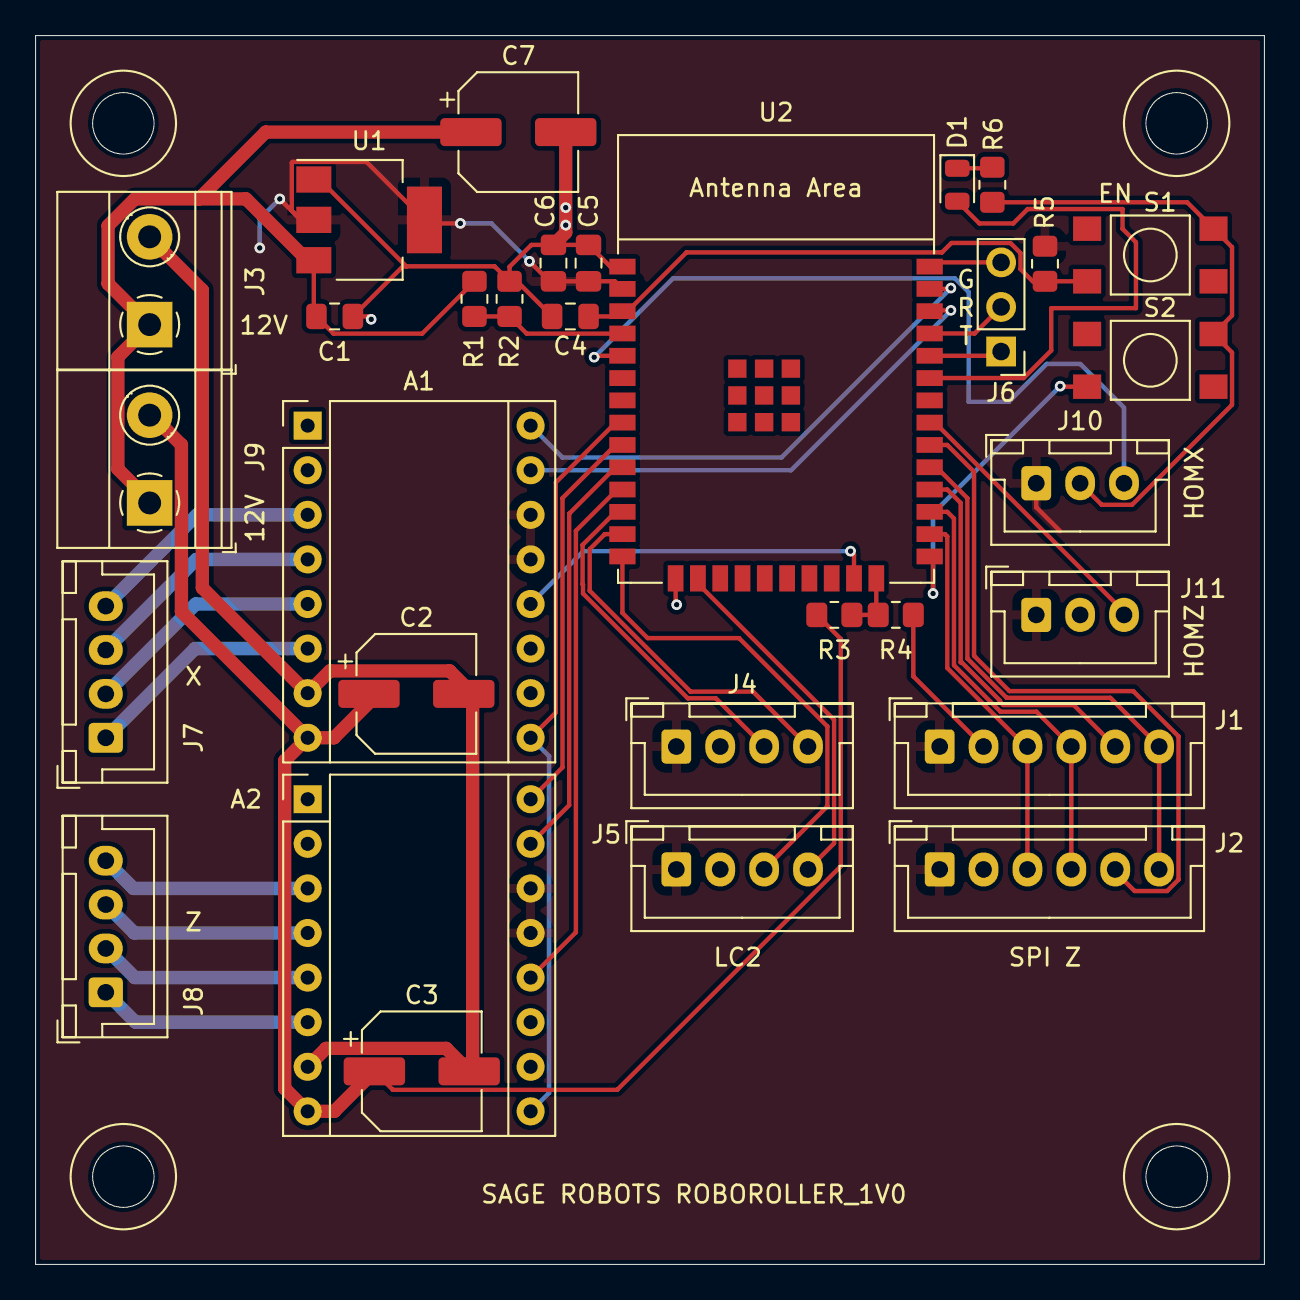
[picture p43: board MuscleRoller.kicad_pcb from above]

Board: 2 copper layers, 70.0 x 70.0 mm, 31 parts (0 on the bottom side), 38 nets.

Parts:
A1, A2: Pololu_Breakout_DRV8825; Pololu_Breakout-16_15.2x20.3mm
C1: 22u; C_0805_2012Metric_Pad1.18x1.45mm_HandSolder
C2, C3, C7: 100u; CP_Elec_6.3x7.7
C4: 1u; C_0805_2012Metric_Pad1.18x1.45mm_HandSolder
C5: 22U; C_0805_2012Metric_Pad1.18x1.45mm_HandSolder
C6: 0.1u; C_0805_2012Metric_Pad1.18x1.45mm_HandSolder
D1: LED; LED_0805_2012Metric
J1, J2: Conn_01x06_Male; JST_XH_B6B-XH-A_1x06_P2.50mm_Vertical
J3, J9: Screw_Terminal_01x02; TerminalBlock_Phoenix_MKDS-1,5-2_1x02_P5.00mm_Horizontal
J4, J5, J7, J8: Conn_01x04_Male; JST_XH_B4B-XH-A_1x04_P2.50mm_Vertical
J6: Conn_01x03_Male; PinHeader_1x03_P2.54mm_Vertical
J10, J11: Conn_01x03_Male; JST_XH_B3B-XH-A_1x03_P2.50mm_Vertical
R1, R3: 47k; R_0805_2012Metric_Pad1.20x1.40mm_HandSolder
R2, R4, R5: 10K; R_0805_2012Metric_Pad1.20x1.40mm_HandSolder
R6: 100; R_0805_2012Metric_Pad1.20x1.40mm_HandSolder
S1, S2: TL3315NF160Q; TL3305AF160QG
U1: AZ1117-3.3; SOT-223-3_TabPin2
U2: ESP32-WROOM-E; ESP32-WROOM-32E

Connections:
+3V3: A1.13 (~RST), A1.14 (~SLP), A2.13 (~RST), A2.14 (~SLP), C5.1, C6.1, J1.1, J2.1, J4.1, J5.1, J10.1, J11.1, R5.1, U1.2 (VO), U2.2 (3V3)
+12V: C1.1, C7.1, J3.1, J9.1, R1.1, U1.3 (VI)
CHARGE: R1.2, R2.1, U2.4 (SENSOR_VP/GPIO36/ADC1_CH0)
CLK: J1.3, J2.3, U2.26 (ADC2_CH0/GPIO4)
CS0: J1.5, U2.28 (GPIO17)
CS1: J2.5, U2.30 (GPIO18)
DIRX: A1.16 (DIR), U2.37 (GPIO23)
DIRZ: A2.16 (DIR), U2.9 (32K_XN/GPIO33/ADC1_CH5)
EN: C4.1, R5.2, S1.1, U2.3 (EN/CHIP_PU)
EN_STEP: A1.9 (~EN), A2.9 (~EN), U2.8 (32K_XP/GPIO32/ADC1_CH4)
ESTOP: R3.2, R4.1, U2.24 (ADC2_CH2/GPIO2)
ESTOP12V: A1.8 (VMOT), A2.8 (VMOT), C2.1, C3.1, J9.2, R3.1
GND: A1.1 (GND), A1.7 (GND), A2.1 (GND), A2.7 (GND), C1.2, C2.2, C3.2, C4.2, C5.2, C6.2, C7.2, J1.2, J2.2, J3.2, J4.2, J5.2, J6.3, J10.2, J11.2, R2.2, R4.2, R6.2, S1.4, S2.4, U1.1 (GND), U2.1 (GND), U2.15 (GND), U2.38 (GND)
HOMX: J10.3, U2.5 (SENSOR_VN/GPIO39/ADC1_CH3)
HOMZ: J11.3, U2.31 (GPIO19)
IO0: S2.1, U2.25 (GPIO0/BOOT/ADC2_CH1)
LC_CLK: J4.3, U2.12 (ADC2_CH7/GPIO27)
LC_CLK2: J5.3, U2.14 (MTDI/GPIO12/ADC2_CH5)
LC_DAT: J4.4, U2.13 (MTMS/GPIO14/ADC2_CH6)
LC_DAT2: J5.4, U2.16 (MTCK/GPIO13/ADC2_CH4)
LED: D1.2 (A), U2.33 (GPIO21)
MISO: J1.4, J2.4, U2.27 (GPIO16)
MOSI: J1.6, J2.6, U2.29 (GPIO5)
MSX: A1.12 (M2), U2.23 (MTDO/GPIO15/ADC2_CH3)
MSZ: A2.12 (M2), U2.11 (DAC_2/ADC2_CH9/GPIO26)
unnamed: D1.1 (K), R6.1
RX: J6.2, U2.35 (U0TXD/GPIO1)
STEPX: A1.15 (STEP), U2.36 (GPIO22)
STEPZ: A2.15 (STEP), U2.10 (DAC_1/ADC2_CH8/GPIO25)
TX: J6.1, U2.34 (U0RXD/GPIO3)
XA1: A1.4 (A1), J7.3
XA2: A1.3 (A2), J7.4
XB1: A1.5 (B1), J7.2
XB2: A1.6 (B2), J7.1
ZA1: A2.4 (A1), J8.3
ZA2: A2.3 (A2), J8.4
ZB1: A2.5 (B1), J8.2
ZB2: A2.6 (B2), J8.1
