SageRobots/RoboRoller/Code/main/MuscleRoller.cpp

#include "freertos/FreeRTOS.h"
#include "freertos/task.h"
#include "freertos/event_groups.h"
#include "esp_wifi.h"
#include "esp_log.h"
#include "nvs_flash.h"
#include "esp_http_server.h"
#include "driver/gpio.h"
#include "esp_sleep.h"
#include "driver/adc.h"
#include "esp_adc_cal.h"
#include <math.h>
#include "stepper.h"
#include "driver/timer.h"
#include "driver/spi_master.h"
#include <hx711.h>
#include "stepper.h"
#include "soc/soc.h"
#include "soc/rtc_cntl_reg.h"
#include <string>

#define WIFI_SSID      CONFIG_ESP_WIFI_SSID
#define WIFI_PASS      CONFIG_ESP_WIFI_PASSWORD
#define DEFAULT_VREF    1100        //Use adc2_vref_to_gpio() to obtain a better estimate
#define TIMER_DIVIDER         16  //  Hardware timer clock divider
#define TIMER_SCALE           (TIMER_BASE_CLK / TIMER_DIVIDER)  // convert counter value to s
#define TIMER_INTERVAL1_S 0.00005
static EventGroupHandle_t wifiEventGroup;
#define WIFI_CONNECTED_BIT BIT0
#define WIFI_FAIL_BIT      BIT1
static int retryNum = 0;
static const char *TAG = "wifi station";   
static esp_adc_cal_characteristics_t *adcCharsCharge, *adcCharsEStop;
static const adc_bits_width_t width = ADC_WIDTH_BIT_12;
static const adc_atten_t atten = ADC_ATTEN_11db;

const gpio_num_t pinDirZ = (gpio_num_t)33;
const gpio_num_t pinStepZ = (gpio_num_t)25;
const gpio_num_t pinMSZ = (gpio_num_t)26;
const gpio_num_t pinEn = (gpio_num_t)32;
const gpio_num_t pinDirX = (gpio_num_t)23;
const gpio_num_t pinStepX = (gpio_num_t)22;
const gpio_num_t pinMSX = (gpio_num_t)15;
const gpio_num_t pinLCClk = (gpio_num_t)27;
const gpio_num_t pinLCDat = (gpio_num_t)14;
const gpio_num_t pinLCClk2 = (gpio_num_t)12;
const gpio_num_t pinLCDat2 = (gpio_num_t)13;
const gpio_num_t pinHomZ = (gpio_num_t)19;
const gpio_num_t pinHomX = (gpio_num_t)21;
const gpio_num_t pinClk = (gpio_num_t)4;
const gpio_num_t pinMOSI = (gpio_num_t)5;
const gpio_num_t pinMISO = (gpio_num_t)16;
const gpio_num_t pinCS0 = (gpio_num_t)17;
const gpio_num_t pinCS1 = (gpio_num_t)18;

const adc1_channel_t pinCharge = ADC1_CHANNEL_0;
const adc2_channel_t pinEStop = ADC2_CHANNEL_2;

//init motors
Stepper motorX(pinStepX, pinDirX, pinHomX, pinCS0, pinMSX, true);
Stepper motorZ(pinStepZ, pinDirZ, pinHomZ, pinCS1, pinMSZ, true);

float battery;

struct cycle {
    bool cycling;
    int step;
    float force;
    float startX;
    float endX;
    float startZ;
    float travelSpeed;
    float speed;
};

struct cycle cycle;

int64_t timeNow;
int64_t timePrint = 0;

const float LC1Zero = 187200; //near side
const float LC125lb = -392000;
const float LC2Zero = -92093; //far side
const float LC225lb = 479727;
float forceL, forceR;

static void event_handler(void* arg, esp_event_base_t event_base,
                                int32_t event_id, void* event_data) {
    if (event_base == WIFI_EVENT && event_id == WIFI_EVENT_STA_START) {
        esp_wifi_connect();
    } else if (event_base == WIFI_EVENT && event_id == WIFI_EVENT_STA_DISCONNECTED) {
        if (retryNum < CONFIG_ESP_MAXIMUM_RETRY) {
            esp_wifi_connect();
            retryNum++;
            ESP_LOGI(TAG, "retry to connect to the AP");
        } else {
            xEventGroupSetBits(wifiEventGroup, WIFI_FAIL_BIT);
        }
        ESP_LOGI(TAG,"connect to the AP fail");
    } else if (event_base == IP_EVENT && event_id == IP_EVENT_STA_GOT_IP) {
        ip_event_got_ip_t* event = (ip_event_got_ip_t*) event_data;
        ESP_LOGI(TAG, "got ip:" IPSTR, IP2STR(&event->ip_info.ip));
        retryNum = 0;
        xEventGroupSetBits(wifiEventGroup, WIFI_CONNECTED_BIT);
    }
}

void wifiInit(void) {
    wifiEventGroup = xEventGroupCreate();

    ESP_ERROR_CHECK(esp_netif_init());

    ESP_ERROR_CHECK(esp_event_loop_create_default());
    esp_netif_create_default_wifi_sta();

    wifi_init_config_t cfg = WIFI_INIT_CONFIG_DEFAULT();
    esp_wifi_init(&cfg);
    esp_event_handler_instance_t instance_any_id;
    esp_event_handler_instance_t instance_got_ip;
    ESP_ERROR_CHECK(esp_event_handler_instance_register(WIFI_EVENT,
                                                        ESP_EVENT_ANY_ID,
                                                        &event_handler,
                                                        NULL,
                                                        &instance_any_id));
    ESP_ERROR_CHECK(esp_event_handler_instance_register(IP_EVENT,
                                                        IP_EVENT_STA_GOT_IP,
                                                        &event_handler,
                                                        NULL,
                                                        &instance_got_ip));
    wifi_config_t wifi_config = {};
    strcpy((char*)wifi_config.sta.ssid, WIFI_SSID);
    strcpy((char*)wifi_config.sta.password, WIFI_PASS);
    wifi_config.sta.threshold.authmode = WIFI_AUTH_WPA2_PSK;
    wifi_config.sta.pmf_cfg.capable = true;
    wifi_config.sta.pmf_cfg.required = false;

    ESP_ERROR_CHECK(esp_wifi_set_mode(WIFI_MODE_STA) );
    ESP_ERROR_CHECK(esp_wifi_set_config(WIFI_IF_STA, &wifi_config) );
    ESP_ERROR_CHECK(esp_wifi_start());

    ESP_LOGI(TAG, "wifi_init_sta finished.");

    //wait for event connected or failed
    EventBits_t bits = xEventGroupWaitBits(wifiEventGroup,
        WIFI_CONNECTED_BIT | WIFI_FAIL_BIT,
        pdFALSE,
        pdFALSE,
        portMAX_DELAY);
    if (bits & WIFI_CONNECTED_BIT) {
        ESP_LOGI(TAG, "connected to ap SSID:%s password:%s",
                 WIFI_SSID, WIFI_PASS);
    } else if (bits & WIFI_FAIL_BIT) {
        ESP_LOGI(TAG, "Failed to connect to SSID:%s, password:%s",
                 WIFI_SSID, WIFI_PASS);
    } else {
        ESP_LOGE(TAG, "UNEXPECTED EVENT");
    }
    ESP_ERROR_CHECK(esp_event_handler_instance_unregister(IP_EVENT, IP_EVENT_STA_GOT_IP, instance_got_ip));
    ESP_ERROR_CHECK(esp_event_handler_instance_unregister(WIFI_EVENT, ESP_EVENT_ANY_ID, instance_any_id));
    vEventGroupDelete(wifiEventGroup);
}

static esp_err_t get_handler(httpd_req_t *req) {
    extern const unsigned char index_html_start[] asm("_binary_index_html_start");
    extern const unsigned char index_html_end[]   asm("_binary_index_html_end");
    const size_t index_html_size = (index_html_end - index_html_start);
    httpd_resp_send_chunk(req, (const char *)index_html_start, index_html_size);
    /* Send empty chunk to signal HTTP response completion */
    httpd_resp_sendstr_chunk(req, NULL);

    return ESP_OK;
}

static esp_err_t get_handler_2(httpd_req_t *req) {
    char*  buf;
    size_t buf_len;
    /* Read URL query string length and allocate memory for length + 1,
    * extra byte for null termination */
    buf_len = httpd_req_get_url_query_len(req) + 1;

    std::string uri = req->uri;

    if (uri == "/status") {
        //return machine status
        int len = snprintf(NULL, 0, "pinHomX,%i,pinHomZ,%i,motorXPos,%.2f", 
            gpio_get_level(motorX.pinHome), 
            gpio_get_level(motorZ.pinHome),
            motorX.position);
        char *result = (char*)malloc(len + 1);
        snprintf(result, len + 1, "pinHomX,%i,pinHomZ,%i,motorXPos,%.2f", 
            gpio_get_level(motorX.pinHome), 
            gpio_get_level(motorZ.pinHome),
            motorX.position);
        httpd_resp_sendstr(req, result);

    } else if (uri == "/stop") {
        motorX.target = motorX.position;
        motorZ.target = motorZ.position;
        motorZ.targetForce = 0;
        cycle.cycling = false;

    } else if (uri.substr(0,8) == "/moveAbs") {
        if (buf_len > 1) {
            buf = (char*)malloc(buf_len);
            if (httpd_req_get_url_query_str(req, buf, buf_len) == ESP_OK) {
                char param[32];
                /* Get value of expected key from query string */
                if (httpd_query_key_value(buf, "x", param, sizeof(param)) == ESP_OK) {
                    ESP_LOGI(TAG, "Found URL query parameter => x=%s", param);
                    motorX.target = atof(param);
                }
                if (httpd_query_key_value(buf, "z", param, sizeof(param)) == ESP_OK) {
                    ESP_LOGI(TAG, "Found URL query parameter => z=%s", param);
                    motorZ.target = atof(param);
                    motorZ.targetForce = 0;
                }
            }
            free(buf);
        }

    } else if (uri.substr(0,7) == "/speeds") {
        if (buf_len > 1) {
            buf = (char*)malloc(buf_len);
            if (httpd_req_get_url_query_str(req, buf, buf_len) == ESP_OK) {
                char param[32];
                /* Get value of expected key from query string */
                if (httpd_query_key_value(buf, "x", param, sizeof(param)) == ESP_OK) {
                    ESP_LOGI(TAG, "Found URL query parameter => x=%s", param);
                    float tempSpeed = atof(param);
                    if(tempSpeed < 40) motorX.speed = tempSpeed;
                    else motorX.speed = 40;
                }
                if (httpd_query_key_value(buf, "z", param, sizeof(param)) == ESP_OK) {
                    ESP_LOGI(TAG, "Found URL query parameter => z=%s", param);
                    motorZ.speed = atof(param);
                }
            }
            free(buf);
        }

    } else if (uri.substr(0,5) == "/home") {
        if (buf_len > 1) {
            buf = (char*)malloc(buf_len);
            if (httpd_req_get_url_query_str(req, buf, buf_len) == ESP_OK) {
                char param[32];
                /* Get value of expected key from query string */
                if (httpd_query_key_value(buf, "axis", param, sizeof(param)) == ESP_OK) {
                    ESP_LOGI(TAG, "Found URL query parameter => axis=%s", param);
                    if(*param == 'x') motorX.home();
                    else if(*param == 'z') {
                        motorZ.home();
                        motorZ.force = 0;
                    }
                }
            }
            free(buf);
        }

    } else if (uri.substr(0,6) == "/force") {
        if (buf_len > 1) {
            buf = (char*)malloc(buf_len);
            if (httpd_req_get_url_query_str(req, buf, buf_len) == ESP_OK) {
                char param[32];
                /* Get value of expected key from query string */
                if (httpd_query_key_value(buf, "f", param, sizeof(param)) == ESP_OK) {
                    ESP_LOGI(TAG, "Found URL query parameter => f=%s", param);
                    motorZ.targetForce = atof(param);
                }
            }
            free(buf);
        }
        
    } else if (uri.substr(0,6) == "/cycle") {
        if (buf_len > 1) {
            buf = (char*)malloc(buf_len);
            if (httpd_req_get_url_query_str(req, buf, buf_len) == ESP_OK) {
                char param[32];
                if (httpd_query_key_value(buf, "startX", param, sizeof(param)) == ESP_OK) {
                    ESP_LOGI(TAG, "Found URL query parameter => startX=%s", param);
                    cycle.startX = atof(param);
                }
                if (httpd_query_key_value(buf, "startZ", param, sizeof(param)) == ESP_OK) {
                    ESP_LOGI(TAG, "Found URL query parameter => startZ=%s", param);
                    cycle.startZ = atof(param);
                }
                if (httpd_query_key_value(buf, "force", param, sizeof(param)) == ESP_OK) {
                    ESP_LOGI(TAG, "Found URL query parameter => force=%s", param);
                    cycle.force = atof(param);
                }
                if (httpd_query_key_value(buf, "endX", param, sizeof(param)) == ESP_OK) {
                    ESP_LOGI(TAG, "Found URL query parameter => endX=%s", param);
                    cycle.endX = atof(param);
                }
                if (httpd_query_key_value(buf, "travelSpeed", param, sizeof(param)) == ESP_OK) {
                    ESP_LOGI(TAG, "Found URL query parameter => travelSpeed=%s", param);
                    cycle.travelSpeed = atof(param);
                }
                if (httpd_query_key_value(buf, "speed", param, sizeof(param)) == ESP_OK) {
                    ESP_LOGI(TAG, "Found URL query parameter => speed=%s", param);
                    cycle.speed = atof(param);
                }
                cycle.cycling = true;
            }
            free(buf);
        }

    } else {
        printf("URI: ");
        printf(req->uri);
        printf("\n");
    }
    return ESP_OK;
}

static httpd_handle_t start_webserver(void) {
    httpd_handle_t server = NULL;
    httpd_config_t config = HTTPD_DEFAULT_CONFIG();
    config.uri_match_fn = httpd_uri_match_wildcard;
    // Start the httpd server
    ESP_LOGI(TAG, "Starting server on port: '%d'", config.server_port);
    if (httpd_start(&server, &config) == ESP_OK) {

        httpd_uri_t get_uri_1 = {
            .uri       = "/",
            .method    = HTTP_GET,
            .handler   = get_handler,
            .user_ctx  = NULL
        };
        httpd_register_uri_handler(server, &get_uri_1);

        httpd_uri_t file_download = {
            .uri       = "/*",
            .method    = HTTP_GET,
            .handler   = get_handler_2,
            .user_ctx  = NULL   // Pass server data as context
        };
        httpd_register_uri_handler(server, &file_download);

        return server;
    }

    ESP_LOGI(TAG, "Error starting server!");
    return NULL;
}

static void stop_webserver(httpd_handle_t server) {
    // Stop the httpd server
    httpd_stop(server);
}

static void disconnect_handler(void* arg, esp_event_base_t event_base, 
                               int32_t event_id, void* event_data) {
    httpd_handle_t* server = (httpd_handle_t*) arg;
    if (*server) {
        ESP_LOGI(TAG, "Stopping webserver");
        stop_webserver(*server);
        *server = NULL;
    }
}

static void connect_handler(void* arg, esp_event_base_t event_base, 
                            int32_t event_id, void* event_data) {
    httpd_handle_t* server = (httpd_handle_t*) arg;
    if (*server == NULL) {
        ESP_LOGI(TAG, "Starting webserver");
        *server = start_webserver();
    }
}

static bool IRAM_ATTR timer_0_isr(void *para) {
    bool stepX = false;
    bool stepZ = false;
    motorX.intrCount++;
    motorZ.intrCount++;

    //motorX
    if(motorX.intrCount >= motorX.intrInterval) {
        motorX.intrCount = 0;

        if(motorX.bPosError) {
            stepX = true;
        }
    }

    //motorZ
    if(motorZ.intrCount >= motorZ.intrInterval) {
        motorZ.intrCount = 0;

        if(motorZ.bPosMode) { //position mode
            if(motorZ.bPosError) {
                stepZ = true;
            }
        } else { //force mode
            if(motorZ.bForceError) {
                stepZ = true;
            }
        }
    }

    if(stepX) gpio_set_level(motorX.pinStep, 1);
    if(stepZ) gpio_set_level(motorZ.pinStep, 1);
    if(stepX | stepZ) {
        //set timer 1 to reset step pins
        uint64_t timer_counter_value = timer_group_get_counter_value_in_isr(TIMER_GROUP_0, TIMER_1);
        timer_counter_value += (uint64_t) (TIMER_INTERVAL1_S * TIMER_SCALE);
        timer_group_set_alarm_value_in_isr(TIMER_GROUP_0, TIMER_1, timer_counter_value);
        timer_group_enable_alarm_in_isr(TIMER_GROUP_0, TIMER_1);
    }

    timer_group_clr_intr_status_in_isr(TIMER_GROUP_0, TIMER_0);
    timer_group_enable_alarm_in_isr(TIMER_GROUP_0, TIMER_0);

    return pdFALSE;
}

static bool IRAM_ATTR timer_1_isr(void *para) {
    timer_group_clr_intr_status_in_isr(TIMER_GROUP_0, TIMER_1);
    gpio_set_level(motorX.pinStep, 0);
    gpio_set_level(motorZ.pinStep, 0);
    return pdFALSE;
}

static void tg0_timer_init(timer_idx_t timer_idx,
                                   timer_autoreload_t auto_reload, double timer_interval_ms) {
    /* Select and initialize basic parameters of the timer */
    timer_config_t config = {
        .alarm_en = TIMER_ALARM_EN,
        .counter_en = TIMER_PAUSE,
        .intr_type = TIMER_INTR_LEVEL,
        .counter_dir = TIMER_COUNT_UP,
        .auto_reload = auto_reload,
        .divider = TIMER_DIVIDER,
    }; // default clock source is APB
    timer_init(TIMER_GROUP_0, timer_idx, &config);

    /* Timer's counter will initially start from value below.
       Also, if auto_reload is set, this value will be automatically reload on alarm */
    timer_set_counter_value(TIMER_GROUP_0, timer_idx, 0x00000000ULL);

    /* Configure the alarm value and the interrupt on alarm. */
    timer_set_alarm_value(TIMER_GROUP_0, timer_idx, timer_interval_ms * TIMER_SCALE);
    timer_enable_intr(TIMER_GROUP_0, timer_idx);
}

static void enc_task(void *arg) {
    //set CS pins high to start
    gpio_set_level(pinCS0, 1);
    gpio_set_level(pinCS1, 1);

    //create SPI
    esp_err_t ret;
    spi_device_handle_t spi;
    spi_bus_config_t buscfg={};
    buscfg.mosi_io_num=pinMOSI;
    // buscfg.data0_io_num=-1;
    buscfg.miso_io_num=pinMISO;
    // buscfg.data1_io_num=-1;
    buscfg.sclk_io_num=pinClk;
    buscfg.quadwp_io_num=-1;
    // buscfg.data2_io_num=-1;
    buscfg.quadhd_io_num=-1;
    // buscfg.data3_io_num=-1;
    // buscfg.data4_io_num=-1;
    // buscfg.data5_io_num=-1;
    // buscfg.data6_io_num=-1;
    // buscfg.data7_io_num=-1;
    // buscfg.max_transfer_sz=0;
    // buscfg.flags=0;
    // buscfg.intr_flags=0;

    spi_device_interface_config_t devcfg={};
    devcfg.command_bits = 0;
    devcfg.address_bits = 0;
    // devcfg.dummy_bits = 0;
    devcfg.mode=1;
    // devcfg.duty_cycle_pos = 128;
    // devcfg.cs_ena_pretrans = 0;
    // devcfg.cs_ena_posttrans = 0;
    devcfg.clock_speed_hz=5000000;
    // devcfg.input_delay_ns = 0;
    devcfg.spics_io_num=-1;   //CS pins manually implemented
    // devcfg.flags = 0;
    devcfg.queue_size = 7;

    ret=spi_bus_initialize(SPI2_HOST, &buscfg, 0);
    ESP_ERROR_CHECK(ret);
    ret=spi_bus_add_device(SPI2_HOST, &devcfg, &spi);
    ESP_ERROR_CHECK(ret);

    while(1) {
        motorX.update(spi);
        motorZ.update(spi);
        vTaskDelay(10 / portTICK_RATE_MS);
    }
}

void loadCell(void *pvParameters) {
    hx711_t dev = {
        .dout = (gpio_num_t)pinLCDat,
        .pd_sck = (gpio_num_t)pinLCClk,
        .gain = HX711_GAIN_A_64
    };

    // initialize device
    while (1)
    {
        esp_err_t r = hx711_init(&dev);
        if (r == ESP_OK)
            break;
        printf("Could not initialize HX711: %d (%s)\n", r, esp_err_to_name(r));
        vTaskDelay(pdMS_TO_TICKS(500));
    }

    // read from device
    while (1)
    {
        esp_err_t r = hx711_wait(&dev, 500);
        if (r != ESP_OK)
        {
            printf("Device not found: %d (%s)\n", r, esp_err_to_name(r));
            continue;
        }

        int32_t data;
        r = hx711_read_data(&dev, &data);
        if (r != ESP_OK)
        {
            printf("Could not read data: %d (%s)\n", r, esp_err_to_name(r));
            continue;
        }

        forceL = 25*(data-LC1Zero)/LC125lb;
        motorZ.force = forceL+forceR;
        // printf("Raw: %d\n", data);

        vTaskDelay(pdMS_TO_TICKS(10));
    }
}

void loadCell2(void *pvParameters) {
    hx711_t dev = {
        .dout = (gpio_num_t)pinLCDat2,
        .pd_sck = (gpio_num_t)pinLCClk2,
        .gain = HX711_GAIN_A_64
    };

    // initialize device
    while (1)
    {
        esp_err_t r = hx711_init(&dev);
        if (r == ESP_OK)
            break;
        printf("Could not initialize HX711: %d (%s)\n", r, esp_err_to_name(r));
        vTaskDelay(pdMS_TO_TICKS(500));
    }

    // read from device
    while (1)
    {
        esp_err_t r = hx711_wait(&dev, 500);
        if (r != ESP_OK)
        {
            printf("Device not found: %d (%s)\n", r, esp_err_to_name(r));
            continue;
        }

        int32_t data;
        r = hx711_read_data(&dev, &data);
        if (r != ESP_OK)
        {
            printf("Could not read data: %d (%s)\n", r, esp_err_to_name(r));
            continue;
        }

        forceR =  25*(data-LC2Zero)/LC225lb;
        motorZ.force = forceL+forceR;
        // printf("Raw: %d\n", data);

        vTaskDelay(pdMS_TO_TICKS(10));
    }
}

void runCycle() {
    switch(cycle.step) {
        case 0: //move to start x and start z
        motorX.target = cycle.startX;
        motorX.complete = false;
        motorX.speed = cycle.travelSpeed;

        motorZ.targetForce = 0;
        motorZ.target = cycle.startZ;
        motorZ.complete = false;
        motorZ.speed = cycle.travelSpeed;
        cycle.step = 10;
        break;

        case 10: //wait for move complete
        if(motorX.complete && motorZ.complete) cycle.step = 20;
        break;

        case 20: //apply force
        motorZ.targetForce = cycle.force;
        motorZ.bForceError = true;
        cycle.step = 25;
        break;

        case 25:
        if(!motorZ.bForceError) cycle.step = 30;
        break;

        case 30: // move to end x
        motorX.speed = cycle.speed;
        motorX.target = cycle.endX;
        motorX.complete = false;
        cycle.step = 40;
        break;

        case 40: //wait for move complete
        if(motorX.complete) cycle.step = 50;
        break;

        case 50: // set force to 0 and move to start z
        motorZ.speed = cycle.travelSpeed;
        motorZ.targetForce = 0;
        motorZ.target = cycle.startZ;
        motorZ.complete = false;
        cycle.step = 60;
        break;

        case 60: //wait for move complete
        if(motorZ.complete) cycle.step = 0;
        break;
    }
}

void zSpeed() {
    float error = fabs(motorZ.targetForce - motorZ.force);
    float kp = 1.5;
    float speed = kp*error;
    if(speed > 20) speed = 20;
    if(speed < 0.5) speed = 0.5;
    motorZ.speed = speed;
}

extern "C" void app_main(void) {
    //Initialize NVS
    esp_err_t ret = nvs_flash_init();
    if (ret == ESP_ERR_NVS_NO_FREE_PAGES || ret == ESP_ERR_NVS_NEW_VERSION_FOUND) {
      ESP_ERROR_CHECK(nvs_flash_erase());
      ret = nvs_flash_init();
    }
    ESP_ERROR_CHECK(ret);
    //connect to WiFi
    wifiInit();
    static httpd_handle_t server = NULL;

    //Register event handlers to stop the server when Wi-Fi is disconnected
    ESP_ERROR_CHECK(esp_event_handler_register(IP_EVENT, IP_EVENT_STA_GOT_IP, &connect_handler, &server));
    ESP_ERROR_CHECK(esp_event_handler_register(WIFI_EVENT, WIFI_EVENT_STA_DISCONNECTED, &disconnect_handler, &server));
    server = start_webserver();

    //configure outputs
    gpio_config_t io_conf;
    io_conf.intr_type = GPIO_INTR_DISABLE;
    io_conf.mode = GPIO_MODE_INPUT_OUTPUT;
    io_conf.pin_bit_mask = 1ULL<<pinDirX|1ULL<<pinStepX|1ULL<<pinMSX|1ULL<<pinEn;
    io_conf.pin_bit_mask |= 1ULL<<pinDirZ|1ULL<<pinStepZ|1ULL<<pinMSZ;
    io_conf.pin_bit_mask |= 1ULL<<pinCS0|1ULL<<pinCS1|1ULL<<pinLCClk|1ULL<<pinLCClk2;
    io_conf.pull_down_en = (gpio_pulldown_t)0;
    io_conf.pull_up_en = (gpio_pullup_t)0;
    gpio_config(&io_conf);

    //configure inputs
    io_conf.intr_type = GPIO_INTR_DISABLE;
    io_conf.mode = GPIO_MODE_INPUT;
    io_conf.pin_bit_mask = 1ULL<<pinHomX|1ULL<<pinHomZ;
    io_conf.pull_down_en = (gpio_pulldown_t)0;
    io_conf.pull_up_en = (gpio_pullup_t)1;
    gpio_config(&io_conf);

    //configure ADCs
    adc1_config_channel_atten(pinCharge, atten);
    adcCharsCharge = (esp_adc_cal_characteristics_t*)calloc(1, sizeof(esp_adc_cal_characteristics_t));
    esp_adc_cal_characterize(ADC_UNIT_1, atten, width, DEFAULT_VREF, adcCharsCharge);
    adc2_config_channel_atten(pinEStop, atten);
    adcCharsEStop = (esp_adc_cal_characteristics_t*)calloc(1, sizeof(esp_adc_cal_characteristics_t));
    esp_adc_cal_characterize(ADC_UNIT_2, atten, width, DEFAULT_VREF, adcCharsEStop);

    tg0_timer_init(TIMER_0, TIMER_AUTORELOAD_EN, TIMER_INTERVAL0_S);
    int *arg = 0;
    timer_isr_callback_add(TIMER_GROUP_0, TIMER_0, timer_0_isr, arg, 0);
    timer_start(TIMER_GROUP_0, TIMER_0);

    tg0_timer_init(TIMER_1, TIMER_AUTORELOAD_DIS, TIMER_INTERVAL1_S);
    timer_isr_callback_add(TIMER_GROUP_0, TIMER_1, timer_1_isr, arg, 0);
    timer_start(TIMER_GROUP_0, TIMER_1);

    xTaskCreate(loadCell, "loadCell", configMINIMAL_STACK_SIZE * 5, NULL, 5, NULL);
    xTaskCreate(loadCell2, "loadCell2", configMINIMAL_STACK_SIZE * 5, NULL, 5, NULL);
    xTaskCreate(enc_task, "enc_task", 1024*2, NULL, configMAX_PRIORITIES, NULL);

    while(1) {
        vTaskDelay(10/portTICK_RATE_MS);
        timeNow = esp_timer_get_time();

        if(motorZ.targetForce != 0) zSpeed();
        if(cycle.cycling) runCycle();
        if(timeNow - timePrint > 1000000) {
            int raw = adc1_get_raw(pinCharge);
            //Convert adc_reading to voltage in mV
            uint32_t voltage = esp_adc_cal_raw_to_voltage(raw, adcCharsCharge);
            battery = (float)voltage*57.0/10000.0;
            //if voltage is too low, deep sleep indefinitely
            if(battery < 9.6) {
                printf("Low battery: %.2f V\n", battery);
                esp_deep_sleep_start();
            }
            adc2_get_raw(pinEStop, width, &raw);
            // raw = adc1_get_raw(pinEStop);
            //Convert adc_reading to voltage in mV
            voltage = esp_adc_cal_raw_to_voltage(raw, adcCharsEStop);
            float eStop = (float)voltage*57.0/10000.0;
            // printf("pinHomX: %i\n", gpio_get_level(motorX.pinHome));
            printf("X %.1f\t Z %.1f\t step %i\n", motorX.position, motorZ.position, cycle.step);
            printf("force %.1f\t FL %.1f\t FR %.1f\n", motorZ.force, forceL, forceR);
            timePrint = timeNow;
        }
    }
}
