SageRobots/RoboRoller/(commit log)

2021-10-22 spring loaded roller
    [MASSAGEBOT-1.0.FCStd, MOTOR-17HS13-0404S-PG27.FCStd, V-WHEEL-2020.FCStd]
2021-10-22 adding load cells
    [LOAD-CELL-4543.FCStd, MASSAGEBOT-1.0.FCStd, MOTOR-17HS13-0404S-PG27.FCStd, SHOULDER-SCREW.FCStd, SPRING.FCStd, V-WHEEL-2020.FCStd]
2021-10-22 finished x axis
    [CARRIAGE-PLATE-Z-1.0.stl, CARRIAGE-PLATE-Z-B-1.0.stl, CARRIAGE-Z-1.0.stl, COUPLER-6-8.FCStd, LC-BRACKET-1.0.stl, LC-BRACKET-B-1.0.stl, LOAD-CELL-4543.FCStd, MASSAGEBOT-1.0.FCStd]
2021-10-27 improved Z carriage
    [CARRIAGE-Z-1.0.stl, LEAD-SCREW-NUT-PLATE-1.0.stl, LOAD-CELL-4543.FCStd, MASSAGEBOT-1.0.FCStd, MOTOR-17HS13-0404S-PG27.FCStd, V-WHEEL-2020.FCStd]
2021-10-28 lower frame
    [LOAD-CELL-4543.FCStd, MASSAGEBOT-1.0.FCStd, MOTOR-17HS13-0404S-PG27.FCStd, V-WHEEL-2020.FCStd]
2021-10-28 x axis ready to build
    [LOAD-CELL-4543.FCStd, MASSAGEBOT-1.0.FCStd, MOTOR-17HS13-0404S-PG27.FCStd, V-WHEEL-2020.FCStd]
2021-10-28 created animation
    [COUPLER-6-8.FCStd, LOAD-CELL-4543.FCStd, MASSAGEBOT-1.0.FCStd, MOTOR-17HS13-0404S-PG27.FCStd, SHOULDER-SCREW.FCStd, SPRING.FCStd, V-WHEEL-2020.FCStd]
2021-10-28 base update
    [CARRIAGE_1V0.stl, CARRIAGE_PLATE_X_1V0.stl, CARRIAGE_PLATE_X_B_1V0.stl, FRAME_SPACER_1V0.stl, LOAD-CELL-4543.FCStd, MASSAGEBOT-1.0.FCStd, MOTOR-17HS13-0404S-PG27.FCStd, MTR_BRACKET_B_1V0.stl]
2021-10-29 base svg
    [LOAD-CELL-4543.FCStd, MASSAGEBOT-1.0.FCStd, MOTOR-17HS13-0404S-PG27.FCStd, V-WHEEL-2020.FCStd]
2021-11-03 PCB complete
    [MuscleRoller.kicad_pcb, MuscleRoller.sch]
2021-11-04 PCB order
    [LOAD-CELL-4543.FCStd, MASSAGEBOT-1.0.FCStd, MOTOR-17HS13-0404S-PG27.FCStd, MUSCLE-ROLLER-1.0.FCStd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]
2021-11-19 Motor gear ratio change
    [LOAD-CELL-4543.FCStd, MOTOR-17HS13-0404S-PG27.FCStd, MTR_BRACKET_X_1V0.stl, MTR_BRACKET_X_B_1V0.stl, MUSCLE-ROLLER-1.0.FCStd, V-WHEEL-2020.FCStd]
2021-11-22 x and z positioning
    x homing
2021-11-24 load cell amp mounting
    [CARRIAGE-PLATE-Z-1.0.stl, CARRIAGE-PLATE-Z-B-1.0.stl, CARRIAGE_PLATE_Z_1V0.stl, LOAD-CELL-4543.FCStd, MOTOR-17HS13-0404S-PG27.FCStd, MUSCLE-ROLLER-1.0.FCStd, V-WHEEL-2020.FCStd]
2021-11-24 x cable carrier
    [CARRIAGE_PLATE_X_1V0.stl, LOAD-CELL-4543.FCStd, MOTOR-17HS13-0404S-PG27.FCStd, MUSCLE-ROLLER-1.0.FCStd, V-WHEEL-2020.FCStd]
2021-12-02 Start of cantilever design
    [AL_BRACKET.FCStd, CARRIAGE_SBR16.FCStd, LOAD-CELL-4543.FCStd, MOTOR-17HS13-0404S-PG27.FCStd, MUSCLE-ROLLER-1.0.FCStd, V-WHEEL-2020.FCStd]
2021-12-02 Frame complete
    [AL_BRACKET.FCStd, CARRIAGE_SBR16.FCStd, LOAD-CELL-4543.FCStd, MOTOR-17HS13-0404S-PG27.FCStd, MUSCLE-ROLLER-1.0.FCStd, SHOULDER-SCREW.FCStd, SPRING.FCStd, V-WHEEL-2020.FCStd]
2021-12-03 Added X motor
    [AL_BRACKET.FCStd, CARRIAGE_SBR16.FCStd, LOAD-CELL-4543.FCStd, MTR_17HS15_1504S.FCStd, MUSCLE-ROLLER-1.0.FCStd, MUSCLE_ROLLER_1V0.FCStd]
2021-12-04 Rail updates
    Added holes
    [AL_BRACKET.FCStd, CARRIAGE_SBR16.FCStd, LOAD-CELL-4543.FCStd, MTR_17HS15_1504S.FCStd, MUSCLE_ROLLER_1V0.FCStd]
2021-12-05 Added Z motor
    [AL_BRACKET.FCStd, CARRIAGE_PLATE_1V0.stl, CARRIAGE_SBR16.FCStd, LC_BRACKET_B_1V0.stl, LC_PCB_BRACKET_1V0.stl, LEAD_NUT_BRACKET_1V0.stl, LEAD_NUT_BRACKET_Z_1V0.stl, LOAD-CELL-4543.FCStd]
2021-12-09 started z guide rail
    [AL_BRACKET.FCStd, CARRIAGE_SBR16.FCStd, LOAD-CELL-4543.FCStd, MTR_17HS15_1504S.FCStd, MUSCLE_ROLLER_1V0.FCStd]
2021-12-10 Z rail design complete
    [AL_BRACKET.FCStd, CARRIAGE-Z-1.0.stl, CARRIAGE_MGN12H.FCStd, CARRIAGE_PLATE_X_1V0.stl, CARRIAGE_PLATE_Z_1V0.stl, CARRIAGE_SBR16.FCStd, LC-BRACKET-1.0.stl, LC-BRACKET-B-1.0.stl]
2021-12-14 renaming parts
    [AL_BRACKET.FCStd, CARRIAGE_MGN12H.FCStd, CARRIAGE_SBR16.FCStd, LOAD-CELL-4543.FCStd, MTR_17HS15_1504S.FCStd, MUSCLE_ROLLER_1V0.FCStd]
2021-12-15 carrier brackets
    [AL_BRACKET.FCStd, CARRIAGE_MGN12H.FCStd, CARRIAGE_SBR16.FCStd, CARRIER_BRACKET_A_1V0.stl, CARRIER_BRACKET_B_1V0.stl, LOAD-CELL-4543.FCStd, MTR_17HS15_1504S.FCStd, MUSCLE_ROLLER_1V0.FCStd]
2021-12-16 base drawing
    [AL_BRACKET.FCStd, CARRIAGE_MGN12H.FCStd, CARRIAGE_SBR16.FCStd, LOAD-CELL-4543.FCStd, MTR_17HS15_1504S.FCStd, MUSCLE_ROLLER_1V0.FCStd, SHOULDER-SCREW.FCStd, SPRING.FCStd]
2021-12-27 Bigger brackets
    [AL_BRACKET.FCStd, AL_BRACKET_A.FCStd, CARRIAGE_MGN12H.FCStd, CARRIAGE_SBR16.FCStd, LOAD-CELL-4543.FCStd, MTR_17HS15_1504S.FCStd, MUSCLE_ROLLER_1V0.FCStd, SHOULDER-SCREW.FCStd]
2022-01-10 X rails and encoder
    [AL_BRACKET.FCStd, AL_BRACKET_A.FCStd, BOM.ods, CARRIAGE_MGN12H.FCStd, CARRIAGE_SBR16.FCStd, LOAD-CELL-4543.FCStd, MTR_17HS15_1504S.FCStd, MUSCLE_ROLLER_1V0.FCStd]
2022-01-11 CAD updates
    [AL_BRACKET.FCStd, AL_BRACKET_A.FCStd, CARRIAGE_MGN12H.FCStd, CARRIAGE_SBR16.FCStd, LOAD-CELL-4543.FCStd, MTR_17HS15_1504S.FCStd, MUSCLE_ROLLER_1V0.FCStd]
2022-01-18 switch to ESP32 from ESP32-S2 for bluetooth
    [MuscleRoller.sch]
2022-01-22 gerber files
    [BOM.ods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]
2022-01-26 BOM updates
    [BOM.ods, BOM_MuscleRoller.ods]
2022-01-28 BOM and CAD updates
    [AL_BRACKET.FCStd, AL_BRACKET_A.FCStd, BOM_MuscleRoller.ods, CARRIAGE_1V0.stl, CARRIAGE_MGN12H.FCStd, CARRIAGE_PLATE_1V0.stl, CARRIAGE_PLATE_X_1V0.stl, CARRIAGE_PLATE_X_B_1V0.stl]
2022-06-04 BOM updates, design fixes
    [AL_BRACKET.FCStd, AL_BRACKET_A.FCStd, BOM_MuscleRoller.ods, CARRIAGE_MGN12H.FCStd, ENC_BRACK_X_1V0.stl, ENC_BRACK_Z_1V0.stl, LOAD-CELL-4543.FCStd, MTR_17HS15_1504S.FCStd]
2022-07-22 encoders working
    [MuscleRoller.sch]
2022-07-24 GPIO pin updates complete
    [MuscleRoller-B_Cu.gbl, MuscleRoller-B_Mask.gbs, MuscleRoller-B_Paste.gbp, MuscleRoller-B_SilkS.gbo, MuscleRoller-Edge_Cuts.gm1, MuscleRoller-F_Cu.gtl, MuscleRoller-F_Mask.gts, MuscleRoller-F_Paste.gtp]
2022-07-25 Magnet brackets for homing
    [AL_BRACKET.FCStd, AL_BRACKET_A.FCStd, CARRIAGE_MGN12H.FCStd, LOAD-CELL-4543.FCStd, MTR_17HS15_1504S.FCStd, MUSCLE_ROLLER_1V0.FCStd, X_MAG_BRACK_1V0.stl, Z_MAG_BRACK_1V0.stl]
2022-07-26 BOM resistor labels
    [BOM_MuscleRoller.ods]
2022-08-04 Speed and homing functional
2022-08-09 R1 R2 labels were positioned incorrectly
    [MuscleRoller.kicad_pcb]
2022-08-10 Load cell cal
    Clock pin 2 needed manual configuration
2022-08-24 Added LED for status, C7 for ESD protection
    [MuscleRoller-B_Cu.gbl, MuscleRoller-B_Paste.gbp, MuscleRoller-B_Silkscreen.gbo, MuscleRoller-Edge_Cuts.gm1, MuscleRoller-F_Cu.gtl, MuscleRoller-F_Mask.gts, MuscleRoller-F_Paste.gtp, MuscleRoller-F_Silkscreen.gto]
2022-08-25 BOM updates, x home sensor position update in CAD
    [AL_BRACKET.FCStd, AL_BRACKET_A.FCStd, BOM_MuscleRoller.ods, CARRIAGE_MGN12H.FCStd, LOAD-CELL-4543.FCStd, MTR_17HS15_1504S.FCStd, MUSCLE_ROLLER_1V0.FCStd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]
